Umayva/Diplom/RemoteFeeling/IDFReport_PCB2.html

Altium customize

# IDF File Translation Report

Date: | | 05.02.2024
Time: | | 11:31:06
Elapsed Time: | | 00:00:00
PCB Filename | : | D:\Documents\Diplom\RemoteFeeling\PCB2.PcbDoc
IDF Board Filename | : | D:\Documents\Diplom\RemoteFeeling\PCB2.brd
IDF Library Filename | : | D:\Documents\Diplom\RemoteFeeling\PCB2.pro

Errors

Back to top

Warnings

Back to top

Save Warnings

Back to top

Save Errors

Back to top

Export Warnings

Back to top

Export Errors

Back to top
