Umayva/Diplom/Разработка электрической схемы и создание действующего макета «.pptx

## Разработка электрической схемы и создание действующего макета «Перчатка с обратной тактильной связью»

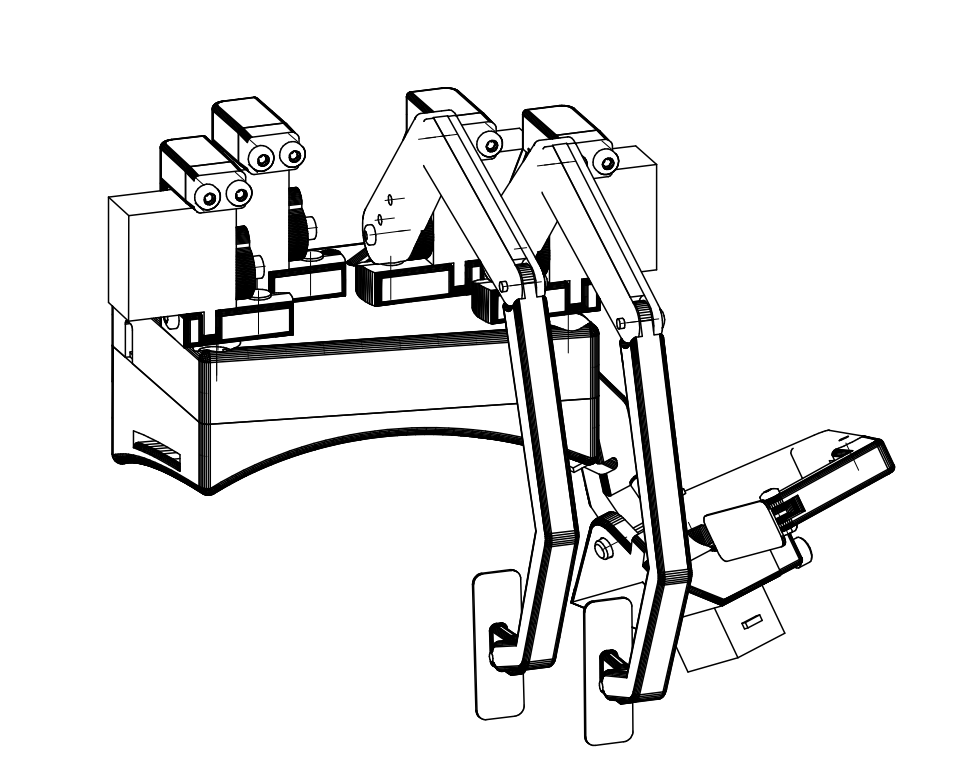
[picture p17: figure]

Выполнил Шамсиев М.А.
Руководитель Загидуллин Р.М.
Рецензент Галиуллин Э.Ф.

ГАПОУ «КРМК»
Гр. ЭПиУ – 460

## Slide 2

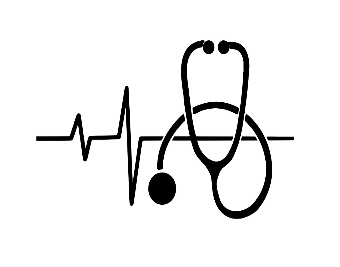
[picture p18: figure]
Picture background
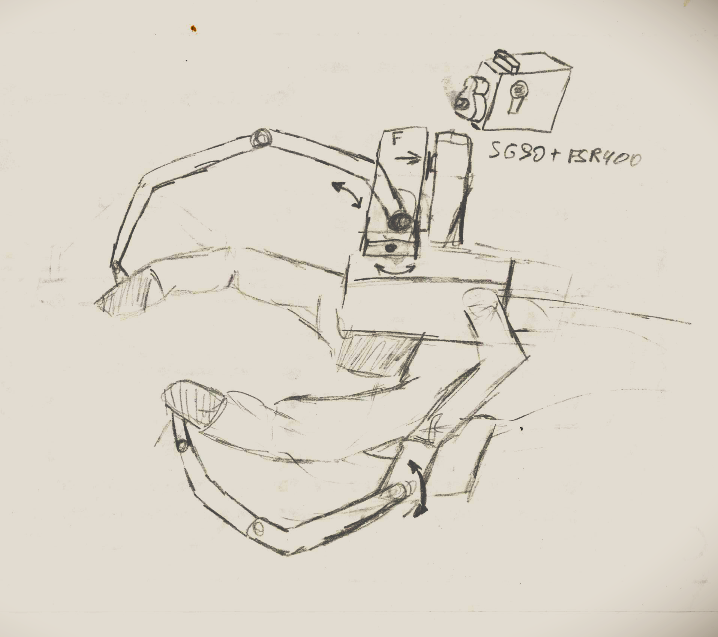
[picture p19: figure]

Медицина

Промышленность

Образование

Виртуальная
реальность

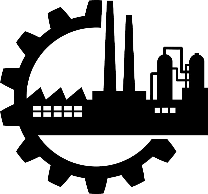
[picture p20: figure]
Picture background
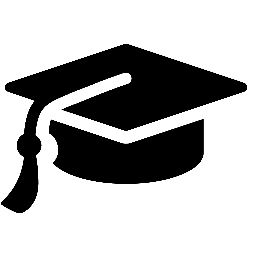
[picture p21: figure]
Picture background
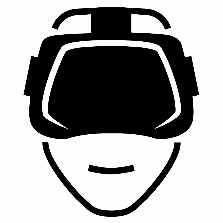
[picture p22: figure]
Picture background
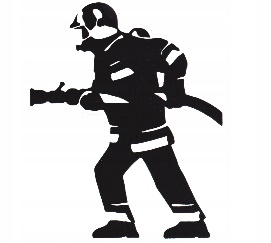
[picture p23: figure]
Picture background

Экстренные
службы

## Slide 3

Требования к прототипу
- Обеспечение полного перечня тактильных ощущений
- Автономность
- Малый удельный вес
- Беспроводная связь
- Низкая себестоимость

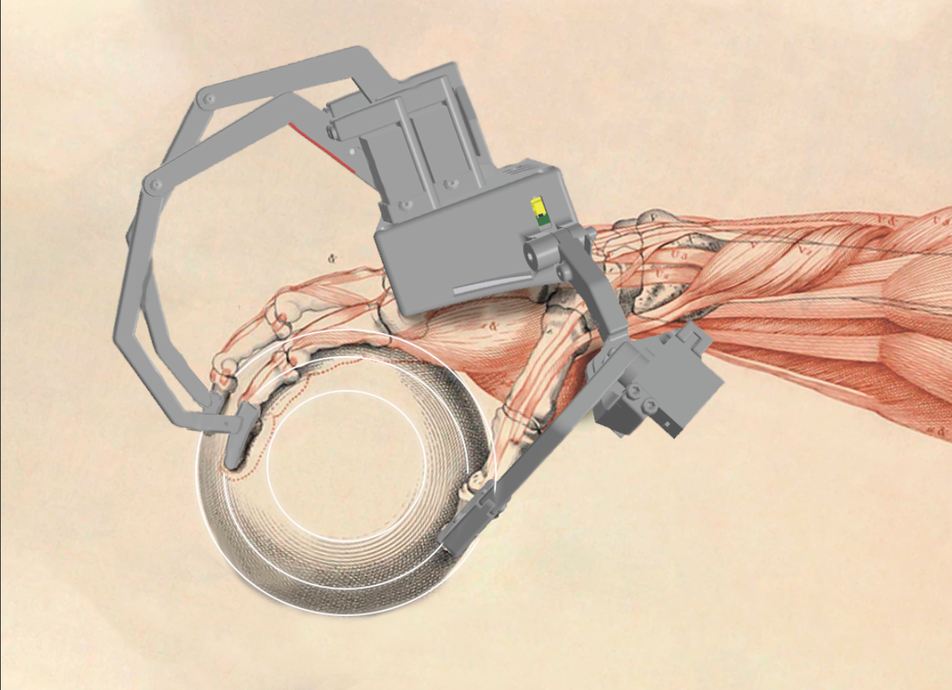
[picture p24: figure]
