Umayva/Diplom/курсовая/ебаный реферфат ПДП.docx

СОДЕРЖАНИЕ

# ВВЕДЕНИЕ

Производственная практика – это практическая часть учебного процесса подготовки квалифицированных рабочих и специалистов, проходящая, как правило на различных предприятиях, в условиях реального производства. Во время производственной практики происходит закрепление и конкретизация результатов теоретического учебно-практического обучения, приобретение студентами умения и навыков практической работы по присваиваемой квалификации и избранной специальности или профессии.

Преддипломная производственная практика: проходила на предприятии: ООО "Эйдос", с 22 апреля 2024 г. по 18 мая 2024 г.; в объеме 144 часа

Цель:

Продемонстрировать способы и методы применения теоретических знаний, полученных в течение семестра, на реальных рабочих местах.

Задачи:

1) Закрепление знаний, полученных на учебной практике

2) Изучение деятельности предприятия

3) Изучение оборудования предприятия

4) Анализ заводского технологического процесса

Приобретение необходимых навыков самостоятельной работы

# 1. Характеристика предприятия

ООО «ЭЙДОС» - это современная, инновационная и быстроразвивающаяся компания, специализирующаяся на разработке и производстве высокотехнологичных медицинских симуляторов под брэндом MedVision.

Результатом сотрудничества ООО «ЭЙДОС» и K.K. DNAFORM (Япония) стало создание в 2014 году компании K.K. MedVision (Япония). В рамках данного партнерства в период с 2014 года по настоящее время совместно были внедрены стандарты качества производства и разработки, созданы и представлены новые линейки симуляторов пациента и хирургических симуляторов, валидированных в Японии, США и Европе.

Поставщики симуляторов MedVision:

1. K.K. MedVision (Токио, Япония):
- Отдел исследований и разработок
- Отдел контроля качества
- Сервисный центр
- Отдел продаж в Японии
2. MedVision, LLC (Орландо, США):
- Сервисный центр
- Отдел продаж в Северной и Южной Америке
3. MedVision, GmbH (Вена, Австрия):
- Производство (ЕС)
- Отдел контроля качества
- Отдел продаж в ЕС
4. ООО «ЭЙДОС» (Казань, Россия):
- Производство
- Отдел исследований и разработок
- Сервисный центр

Схематично структуру подразделения нашего можно предоставить следующим образом (рисунок 1). Она не сильно отличается от среднестатистической структуры предприятия, т.к. и само предприятие не сильно отличается от большинства предприятий среднего бизнеса у нас в стране.

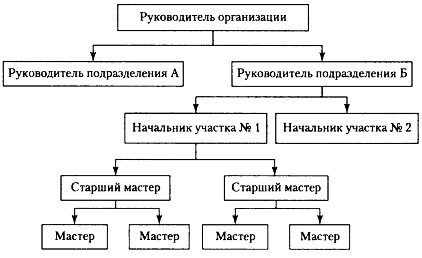
[picture p25: figure]

Рисунок 1 – структурная схема подразделения организации «ООО Эйдос»

# 2. ПРИНЦИП РАБОТЫ УСТРОЙСТВА И ПРИНЦИПИАЛЬНАЯ ЭЛЕКТРИЧЕСКАЯ СХЕМА

Принципиальная электрическая схема показана на рисунке 2.1. Устройство состоит из следующих функциональных частей:

- Датчики усилия, микровибро-мотор, сервоприводы, управляемые напрямую микроконтроллером (на данной схеме не указан, считается внешним элементом),
- Управляющего микроконтроллера DD2 ESP32-WROOM32E,
- Преобразователя интерфейса USB в UART DD4.
- Стабилизирующие цепи на стабилизаторах AMS1117 и LM7805
- Модуль зарядки на микросхеме DD1 TP5100 и цепь питания


Рисунок 2.1 - Принципиальная перчатки с обратной тактильной связью

Датчики усилия выведены на проводах через разъем XP8 представляют из себя тензорезистор включенный в цепь делителя напряжения через резисторы R11-R15 и для стабилизации данных датчика добавлены керамические конденсаторы С14-С18 и С21-С25 они монтируются в плату по необходимости

Основой вибромодуля является плоский микровибро-мотор, подключаемый в цепь через провод разъёмом XP4. Мотор работает от напряжения 3.3В и под него выделена отдельная цепь питания который рассмотрим позднее. Параллельно мотору подключен защитный диод VD1.

Для управление вибрацией микроконтроллером мы используем н-канальный MOSFET транзистор VT2 который работает в режиме ключа. Для обеспечения работы транзистора используем токоограничивающий резистор R7 и для разрядки затвора транзистора резистор R8.

Основой данного проекта являются переработанные сервоприводы sg90. Они подключены через шлейф разъемами XP1-XP6. Они были пронумерованы индексами T, I, M, R, P в соответствии с английскими наименованиями пальцев, далее в описании выводов будет справедливо отнести их каждому из индексов символом «*»

У них была выпаяна управляющая микросхема, таким образом мы подключаемся к драйверу мотора напрямую получая выводы *M1 и *M2.

Потенциометр сервопривода был изолирован из управляющей платы и получила выводы 3.3В и *E.

Питание пальцевые сервоприводы получают с выводов VCC и GND


Рисунок 2.2 – принципиальная схема управляющего микроконтроллера

За логику работы и реализации функционала устройства отвечает центральный микроконтроллер DD2 ESP 32 - WROOM32E.

ESP32 представляет собой серию недорогих, маломощных микроконтроллеров (https://en.wikipedia.org/wiki/System_on_a_chip) со встроенным Wi-Fi (https://en.wikipedia.org/wiki/Wi-Fi) и двухрежимным Bluetooth (https://en.wikipedia.org/wiki/Bluetooth).

В серии ESP32 используется либо микропроцессор Tensilica (https://en.wikipedia.org/wiki/Tensilica) Xtensa LX6 как в двухъядерном, так и в одноядерном (https://en.wikipedia.org/wiki/Single-core) исполнении, двухъядерный микропроцессор Xtensa LX7, либо одноядерный (https://en.wikipedia.org/wiki/Single-core) RISC-V (https://en.wikipedia.org/wiki/RISC-V) и включает встроенные антенные переключатели, радиочастотный (https://en.wikipedia.org/wiki/Radio_frequency) балун (https://en.wikipedia.org/wiki/Balun), усилитель мощности, малошумящий приемный усилитель, фильтры и модули управления питанием. ESP32 создан Espressif Systems (https://en.wikipedia.org/wiki/Espressif_Systems), китайской компанией, базирующейся в Шанхае, и производится TSMC (https://en.wikipedia.org/wiki/TSMC) по их 40-нм технологическому процессу.

Характеристики

- Процессоры:
  - Процессор: двухъядерный (или одноядерный) 32-разрядный микропроцессор Xtensa LX6, работающий на частоте 160 или 240 МГц и производящий до 600 DMIPS (https://en.wikipedia.org/wiki/Dhrystone)
  - Сопроцессор со сверхнизким энергопотреблением (ULP)
- Оперативная память: 520 Кб ОЗУ, 448 КБ ПЗУ
- Беспроводное подключение:
  - Wi-Fi: 802.11 (https://en.wikipedia.org/wiki/IEEE_802.11) b / g / n
  - Bluetooth: версии 4,2 с поддержкой EDR и BLE (совместно использует радио с Wi-Fi)

Питание микроконтроллера обеспечивается стабилизированным напряжением 3.3В. Для защиты от низкочастотных высокочастотных используем конденсаторы C1 и C2.

В качестве токоограничивающих резисторов на выводах последовательного интерфейса используем резистор R4 и R6.

Светодиод VD2 используется для индикации режима сброса, R3 в качестве токоограничения светодиода

Для ввода микроконтроллера в режим прошивки подтягиваем вывод IO0 к земле через тактовую кнопку SB2, для сброса микроконтроллера подтягиваем вывод EN к земле через кнопку SB1.

R5 и C3 для стабилизации работы процесса сброса


Рисунок 2.3 - Принципиальная схема преобразователя USB интерфейса в UART

DD4 CH340C - это микросхема-преобразователь шины USB, которая преобразует USB в последовательный порт или порт принтера. В режиме UART CH340 обеспечивает стандартные модемные сигналы, используемые для расширения последовательного порта для компьютеров или перехода непосредственно с обычного последовательного устройства на шину USB.

Цепь из транзисторов VT1 и VT3 служат для инициализации микросхемы DD4 с микроконтроллером. Резисторы R1 и R2 подключены к базам транзисторов для ограничения тока.

Для удобной прошивки устройства и связи с компьютером мы используем разъем Х1 micro USB. Для защиты прибора от воздействия статического электричества сигналы с разъема Х1 проходят через микросхему DD3 USB LC6 и конденсатор С4 для стабилизации.


Рисунок 2.4 - Принципиальная схема стабилизирующих цепей на стабилизаторах AMS1117

Питание 5В поступает на плату через разъем XP10. Для контроля мы используем кнопку SB1, он не монтируется на плате, а выведен за пределы корпуса проводами для легкого доступа. Диод шоттки VD3 B5819WS выполняет роль защиты от переполюсовки. Для индикации напряжения питания светодиод красного цвета VD7 и резистор R9 для его работы.

Стабилизаторы напряжения DA3 и DA2 представлены по класической схеме стабилизации от частотных помех с использованием конденсаторов C5 C6 C10 C11.


Рисунок 2.5 - Принципиальная схема цепи питания с модулем зарядки

Питание устройства обеспечивают два последовательно подключенных li-ion батареи G2 и G1

Характеристики

- Напряжение 3.5 В
- Емкость 3000 мАч
- Формфактор 18650

Батареи при последовательном соединении обеспечивают напряжение 8В, для преобразования этого значения до стабильных 5В используется стабилизатор DA1 LM7805

Для зарядки аккумуляторов был построен на базе микросхемы DD1 TP5100 - одна из наиболее широко используемых микросхем контроллера зарядки аккумулятора / BMS. Это простая и экономичная микросхема, предназначенная для портативных электронных устройств большой мощности. Одним из основных преимуществ микросхемы TP5100 является ее компактная и простая внешняя схема, для функционирования которой требуется всего несколько основных дополнительных компонентов.

Он имеет несколько функций безопасности для защиты аккумулятора и зарядного устройства от повреждений.

Обвязка микросхемы был выполнен согласно требованиям документации микросхемы TP5100

# 3. РАЗРАБОТКА КОНСТРУКЦИИ УСТРОЙСТВА

## 3.1 Описание конструкции


Устройство выполнено в виде отдельного конструктивного блока РЭА на рисунке 4.1

Рисунок 3.1 – внешний вид перчатки

При разборе заводских аналогов была выявлена самая главная проблема.

Средняя стоимость решений от компаний составляет от 250тыс рублей.

Наша задача, не теряя основной идеи подобного устройства разработать решение дешевле 20тыс рублей.

Требование к конструкции прототипа:

- Автономная работа
- Малый удельный вес устройства
- Беспроводная связь

## 3.2 Автономность

Одним из ключевых элементов, обеспечивающих автономность устройства, является отсутствие необходимости подключения к стационарным источникам питания через провода. Это особенно важно в нашем случае, поскольку наше устройство будет использоваться для виртуальных симуляций, где для достижения максимальной погруженности желательно избежать любых препятствий или ограничений для пользователя.


Исходя из вышеуказанных причин, мы приняли решение оснастить устройство аккумуляторной сборкой, состоящей из аккумуляторов 18650. Выбранные аккумуляторы имеют емкость 3000мАч, что позволяет обеспечить устройству достаточную энергию для продолжительной работы без необходимости подключения к сети электропитания. (Рисунок4.2)

Рисунок 3.2 – 3Д модель блока питания

## 3.3 Эргономика и развесовка

При использовании устройства необходимо обеспечить комфортное ощущение пользователю даже при длительной работе с ним. В процессе разработки перчатки особое внимание было уделено анатомическим особенностям среднего человека, чтобы создать корпус, который обеспечивает оптимальный уровень комфорта при использовании. Детально продуманная эргономика корпуса позволяет снизить вероятность возникновения дискомфорта или усталости при взаимодействии с устройством на протяжении длительного времени. (Рисунок3.3)


Рисунок 3.3 – Разработка эргономики корпуса

Одним из важнейших аспектов эргономики являются габаритные и весовые характеристики устройства. Эти параметры ограничивают возможности автономности устройства. Поскольку было принято решение использовать аккумуляторную сборку для питания, размещение ее в корпусе оказалось невозможным.

Во-первых, устройство стало бы слишком громоздким при таких габаритах. Во-вторых, вес блока питания составляет 260 грамм, а с учетом массы других компонентов и корпуса общий вес составляет 430 грамм. Такой вес может вызвать значительный дискомфорт уже после 15 минут активного использования, поскольку запястье будет нести на себе значительную часть нагрузки.


Исходя из вышеупомянутых причин, было принято решение вынести блок питания за пределы корпуса устройства. Детали конструкции блока питания представлены на рисунке 3.3. Однако использование длинного провода также может быть неудобным, поэтому сборка аккумуляторов будет крепиться к предплечью пользователя. Это не только решит проблему с весом, но и позволит равномерно распределить нагрузку по всей руке (Рисунок 3.4).

Рисунок 3.4 – Распределение нагрузки

## 3.4 Беспроводная связь

В целях обеспечения полной автономности перчатки, необходимо, помимо использования переносного источника энергии, также организовать беспроводную связь с внешними устройствами. С этой целью был выбран ESP32 в качестве микроконтроллера, который обладает встроенными функциями Wi-Fi и Bluetooth, что обеспечивает возможность установки беспроводной связи между перчаткой и другими устройствами. Кроме того, ESP32 имеет контакты для аналого-цифровых преобразователей (АЦП) и цифро-аналоговых преобразователей (ЦАП).

Технология BLE (Bluetooth Low Energy), как следует из ее названия, потребляет значительно меньше энергии чем классический (classic) Bluetooth. Это достигается при помощи передачи данных по требованию с заранее определенными периодическими обновлениями. Но в отличие от классического Bluetooth технология BLE не используется для передачи файлов или музыки. Наверное, вы были неоднократно удивлены тем, что когда вы подключаете к вашему смартфону какой-нибудь фитнес браслет или умные часы, то вы в своем смартфоне можете посмотреть и уровень заряда батареи подключенного устройства – этот функционал становится доступен благодаря использованию технологии BLE. Данная технология работает вместе с версией Bluetooth V4.0 и может использоваться в серверных или клиентских устройствах, что делает ее чрезвычайно удобной для применения в умных часах, фитнес браслетах и т.д.

Классический Bluetooth, в то же время, достаточно удобен для передачи файлов и других данных. Практически все BLE устройства поддерживают и функционал классического Bluetooth.

Bluetooth, который используется в модулях подобных HC-05, является версией классического Bluetooth и называется Bluetooth SSP (Serial Port Protocol – протокол последовательного порта), что означает то, что в данном случае Bluetooth использует стандартный последовательный протокол.

В данной статье мы будем использовать функционал Serial Bluetooth (последовательного) в модуле ESP32 для его соединения со смартфоном, на котором запущено приложение Bluetooth Terminal. Из данного приложения мы будем передавать команды, с помощью которых мы будем включать/выключать встроенный светодиод модуля ESP32.

## 3.2 Расчет функционального узла печатной платы

В данной дипломной работе электрическая схема задается, чтобы произвести разработку конструкции и решение других конструкторских задач. Данная схема не имеет перечня элементов, а их название и номиналы указываются непосредственно на схеме. В связи с этим, ознакомившись со схемой, возникает необходимость в дополнении и уточнении элементной базы и произвести разработку трассировки печатной платы. Для решения этих задач об элементной базе нужно знать:

1. Габаритные (установочные) размеры, XU*YU*ZU.

2. Массу, ME.

3. Рабочие напряжение и мощность.

Трудность выбора элементной базы заключается в том, что на данный момент большое многообразие элементов с разными характеристиками и конструкциями. Также вызывает затруднение выбор подходящих коммутационных изделий.

Результаты анализа и выбора элементной базы представлены в таблице 3.1

Таблица 3.1 Результаты анализа и выбора элементной базы

Название | Тип | Рисунок с размерами | Масса, г | Место установки
| | | | ПП | ЛП | ЗП

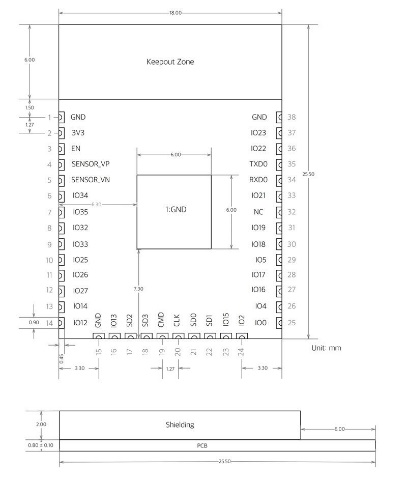
[picture p26: figure]
Picture background

микроконторллер Wi-Fi ESP WROOM 32 | | | 2,18 | +

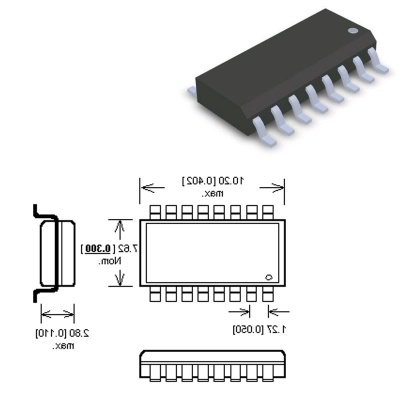
[picture p27: figure]
Picture background

CH340C, Преобразователь интерфейса USB в UART [ | SOP-16 | | 0.4 | +

Продолжение таблицы 3.1 Результаты анализа и выбора элементной базы

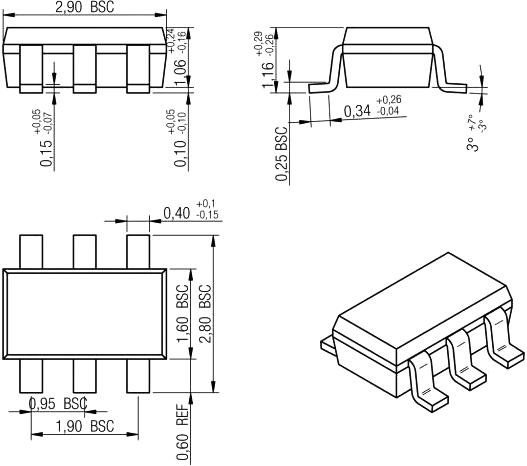
[picture p28: figure]
Picture background

USBLC6-2SC6 | SOT-23-6 | | 0,1 | +

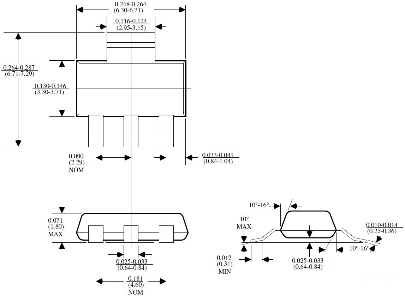
[picture p29: figure]
Picture background

AMS1117-3,3 | SOT-223 | | 0,39 | +

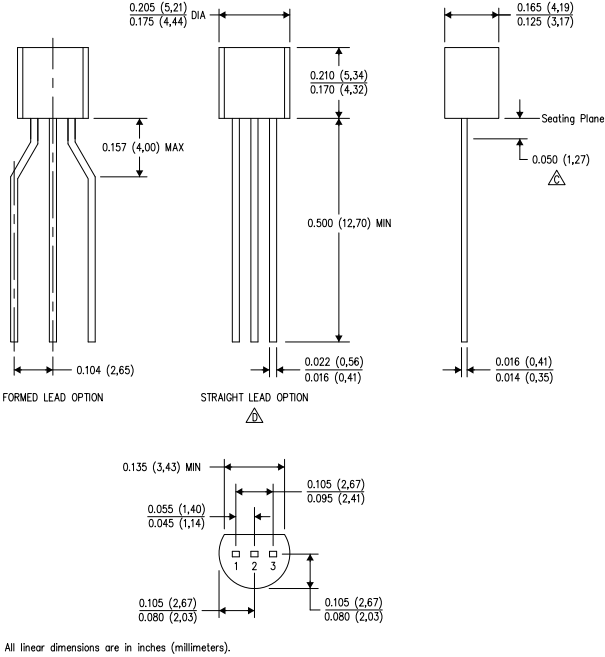
[picture p30: figure]
Picture background

2N7000 | TO-92 | | 0,3 | +

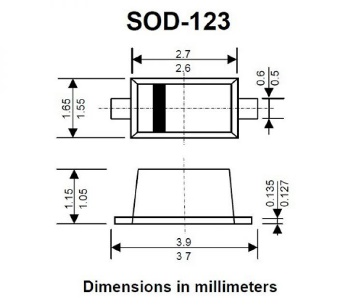
[picture p31: figure]
Picture background

1N4148W, | SOD-123 | | 0,05 | +

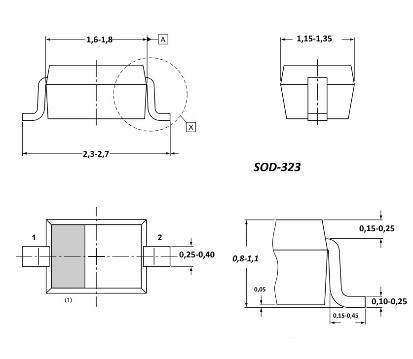
[picture p32: figure]
Picture background

B5819WS, | SOD-323 | | 0,1 | +

Продолжение таблицы 3.1 Результаты анализа и выбора элементной базы

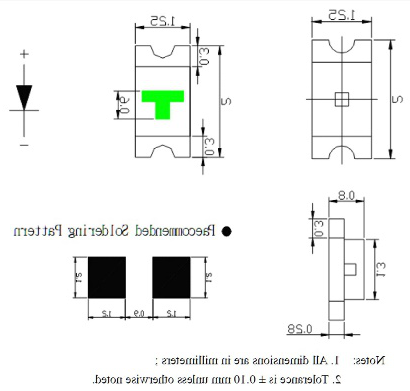
[picture p33: figure]
Picture background

GNL-0805SR | 0805 | | 0,1 | +

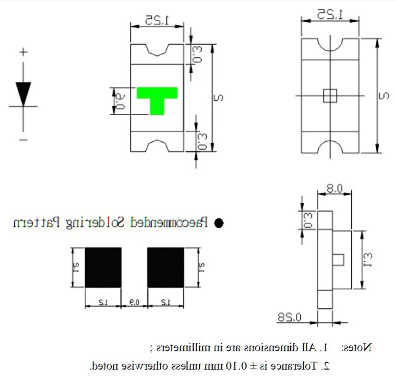
[picture p34: figure]
Picture background

GNL-0805GC | 0805 | | 0,1 | +

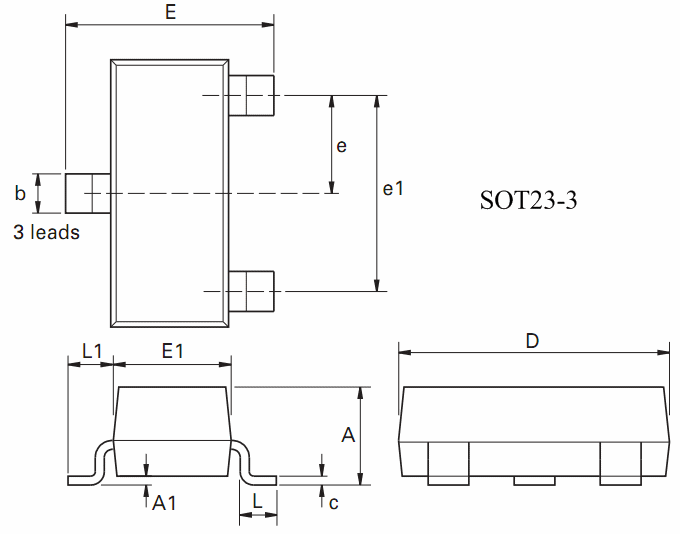
[picture p35: figure]
Picture background

S8050 | SOT-23-3 | | 0,05 | +

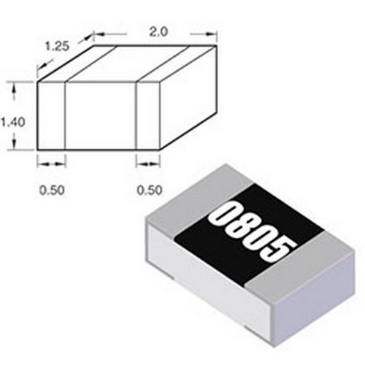
[picture p36: figure]
Picture background

0,1мкф X7R 100в 10% | 0805 | | 0,01 | +

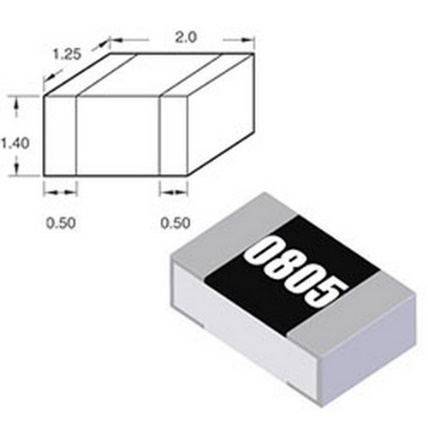
[picture p37: figure]
Picture background

10 мкФ X5R 16В 10% | 08085 | | 0,01 | +

Продолжение таблицы 3.1 Результаты анализа и выбора элементной базы

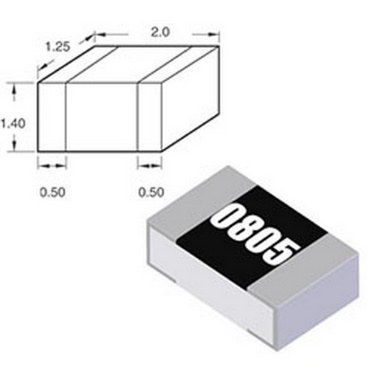
[picture p38: figure]
Picture background

100кОм +0.1% | 0805 | | 0,01 | +

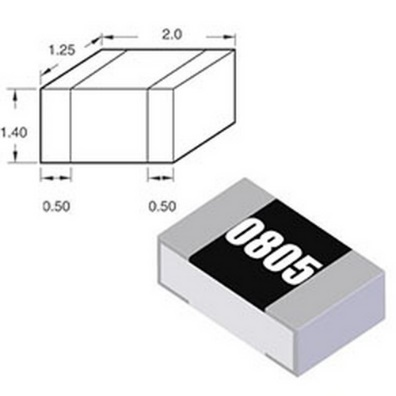
[picture p39: figure]
Picture background

2кОм ±5% 0.125Вт | 0805 | | 0,01 | +

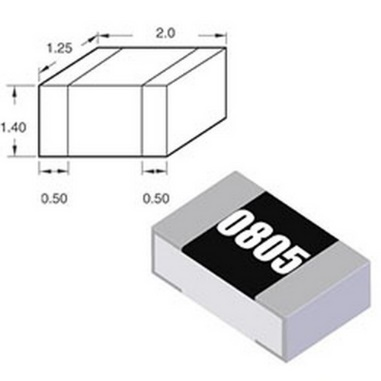
[picture p40: figure]
Picture background

470 Ом, 1% | 0805 | | 0,01 | +

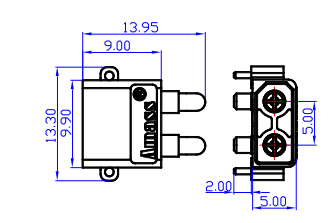
[picture p41: figure]

XT30PW-M, | | | 1

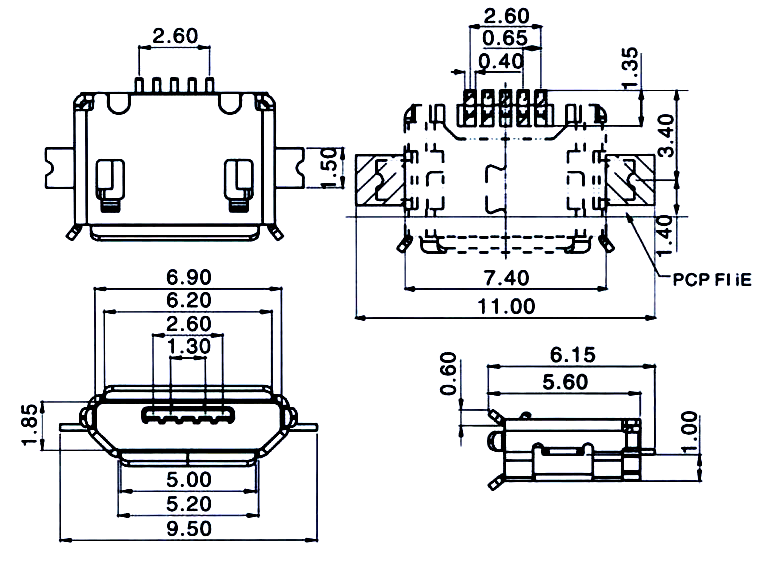
[picture p42: figure]
Picture background

47346-0001 | | | 0,25

Продолжение таблицы 3.1 Результаты анализа и выбора элементной базы

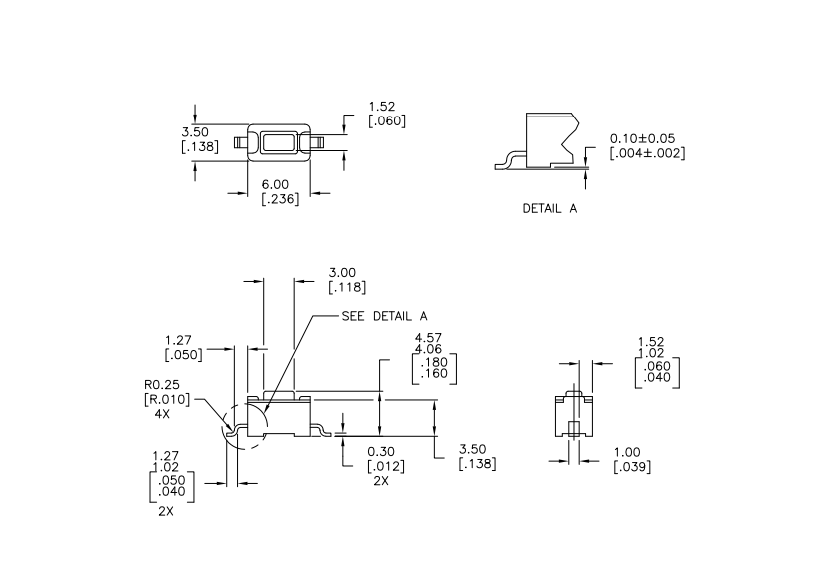
[picture p43: figure]

1437566-3 (FSMSM) | | | 0,13

Предпочтительная форма печатной платы. Она определяется XP, YP, h и коэффициентом формы CF=XP/YP,

ХР> YP; X1, X2, Y1, Y2-краевые поля, необходимые для удобства изготовления и закрепления платы.

XF*YF=SF - размеры и площадь функциональной области, где размещаются элементы электрической схемы и соединительные пробойники.

Площадь, занимаемая элементами на плате.

Вычисляется по формуле (1) и равняется:

CE=∑_(i=1)^n SU_i =769.18мм^2 (1)

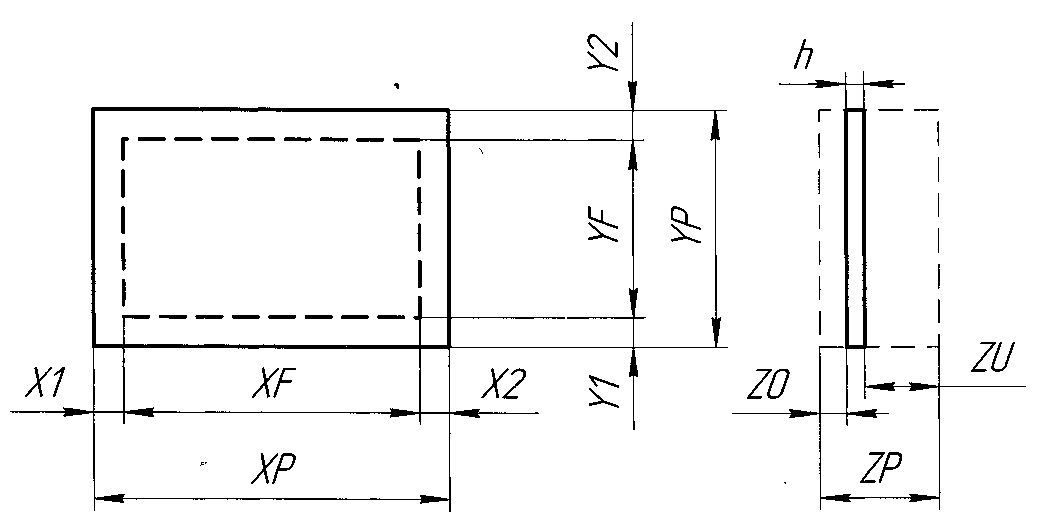
[picture p44: figure]

Рисунок 3.5 - Размеры печатной платы

Согласно рисунка 3.5 размеры печатной платы - определяются размерными цепочками:

XP=X1+XF+X2 (2a)

YP=Y1+YF+Y2 (2б)

Размеры печатного узла по третьей координате-

ZP=ZUmax+h+ZOmax (3)

(h-толщина материала печатной платы)

h=0,5мм

ZP=11+0,5+1=12,5мм

CZ-коэффициент заполнения по площади.

При равенстве CZ(X)=CZ(Y)=√CZ,

CZ-статическая Величина и составляет CZ=0,304

С учётом зазоров между элементами, площадь функциональной поверхности платы найдётся по формуле (4) как

SF=(SE)/(CZ)=1216/0.304=4000мм^2 (4)

Ширина краевых полей выбирается кратной шагу координатной сетки X1,X2,Y1,Y2 = 2,5

Коэффициент формы платы CF=XF/YF=XP/YP,

согласно ГОСТ 10716-81 1≤CF≤3;

CF=1,6

Диаметр контактной площадки согласно рис 4.6 а, находится как DK=2xXA+D=2 0,7+0,8=2,2 мм

где ХА - ширина проводника, D-диаметр отверстия в плате для установки вывода элемента DV, рис 4.6 б.

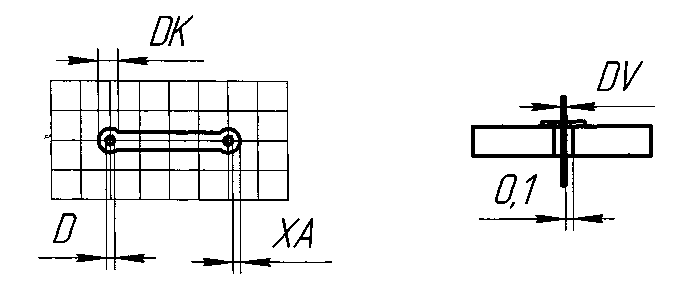
[picture p45: figure]

а б

Рисунок 4.6 (а, б) - Размер контактной площадки

Для каждой толщины подсчитаем значение диаметра контактной площадки

D1=DV1+0,2=0,5+0,2=0,7 мм

D2=DV2+0,2=0,6+0,2=0,8 мм

Выбираем D1=D2=0,8 мм

В данном случае целесообразно использовать следующие размеры печатной платы

XP=X1+XF+X2=2,5+75+2,5=80 мм

YP=Y1+YF+Y2=2,5+45+2,5=50 мм

Получен коэффициент прямоугольности 1,6

Размеры плоты XP XYP=80*50 мм

Функциональные узлы, использующие интегральные схемы, работают на токах, не превышающие 10⁻²...10⁻⁴А через проводники сигнальных цепей.

В данном устройстве токи не могут превышать 1СГ3А. Ширину проводника ХА возьмём равной 0,3мм. Удельная плотность тока через печатного проводника равный - 25 А/мм².

Подсчитаем значение толщины фольги по формуле (5):

TF=(10^(-3))/(y*XA)=(10^(-3))/(25*03)=14мкм (5)

В результате расчётов получилось толщина фольги 14 мкм, возьмём стандартную толщину фольги 18 мкм.

Полученные габаритные размеры функционального узла - 80х50х0,5мм подходящей материал для изготовления печатной платы - стеклотекстолит, фольгированный гальваностойкий СФ-2-18-Г.

# 4. ЭКОНОМИЧЕСКИЙ РАЗДЕЛ

## 4.1 Общие положения

Задачей экономической части дипломной является расчёт затрат на изготовление изделия «Перчатка с обратной тактильной связью» при серийном производстве на предприятии.

Расходы предприятия - это расходы, связанные с изготовлением и продажей продукции, приобретением и перепродажей товаров, выполнением работ или оказанием услуг. Совокупность всех расходов предприятия, возникающих в процессе переработки материально-производственных запасов для целей производства продукции и её продажи.

- материальные затраты;

- затраты на оплату труда;

- отчисления на социальные нужды;

- амортизация основных фондов;

При этом по элементу «Материальные затраты» отражается стоимость покупных основных и вспомогательных материалов, изделий, топлива, энергии, услуг производственного характера сторонних организаций. Их стоимость формируется исходя из цен приобретения (без учёта НДС), включая наценку (надбавку), комиссионное вознаграждение, оплату брокерских и иных посреднических услуг. Оплата труда и отчисления на социальные нужды отражаются только применительно к персоналу основной деятельности.

Элемент «Амортизация основных фондов» учитывает величину амортизационных отчислений на полное восстановление основных производственных фондов, сумма которых, определяется на основании их балансовой стоимости и действующих норм амортизации. В элемент

«Прочие затраты» включаются некоторые виды сборов и платежей, отчисления в специальные внебюджетные фонды, платежи за предельно допустимые выбросы загрязняющих веществ и другие.

В процессе анализа учитывается удельный вес каждого элемента затрат в общей сумме себестоимости, исходя из особенностей тех или иных отраслей. Затраты, формирующие себестоимость продукции, составляют подавляющую часть расходов предприятия. Поэтому их величина напрямую влияет на размер прибыли, получаемой предприятием.

Расчет затрат на элементную базу

Для расчета затрат на элементную базу необходимо составить перечень необходимых элементов и рассчитать их стоимость. В таблице 4.2 перечислены элементы, необходимые для создания прототипа прерчатки:

Цэ= ∑ э*Р (6)

Где: Цэ - цена элементов (руб.);

∑э – количество элементов;

Р – цена одного элемента (руб.)

Таблица 4.2 Список деталей

№ | Название | Цена за партию с НДС 20% (руб) | Количество деталей в партии (Ед) | Цена за деталь (руб) | Количество деталей на единицу изделия | Цена на еденицу изделия (руб)
1 | печатная плата jlcpcb 5шт | 1 789,2 | 5 | 357.8 | 1 | 357.8
2 | Датчик давления FSR400 | 187,2 ₽ | 1 | 187,2 ₽ | 5 | 936.0
3 | Сервопривод sg90 5шт | 1 208,4 ₽ | 5 | 240 | 5 | 1 208,4
4 | Шлейф 1.2мм 9жил 2м | 223.2 | 2 | 111.6 | 1.5 | 167.4
5 | Винт с шестигранной головкой ISO7380 М2,5х16 | 181,2 | 50 | 3.6 | 5 | 18.1
6 | Винт с шестигранной головкой ISO7380 М2х10 | 141,6 | 50 | 2.8 | 5 | 14.2
7 | 3x4x6 Низкопрофильный прецизионный плечевой винт из нержавеющей стали 18-8 | 343,1 | 1 | 343,1 | 1 | 343,1
8 | 3x4x4 Низкопрофильный прецизионный плечевой винт из нержавеющей стали 18-8 | 274,1 | 1 | 274,1 | 4 | 1096.3
9 | 3x4x16 Низкопрофильный прецизионный плечевой винт из нержавеющей стали 18-8 | 343,1 | 1 | 343,1 | 1 | 343,1
10 | Плоский вибромотор BVM 1027 10мм 3В для Arduino проектов CT Retail | 180,0 | 1 | 180,0 | 1 | 180,0
11 | микроконторллер Wi-Fi ESP WROOM 32 | 312,0 | 1 | 312,0 | 1 | 312,0
12 | CH340C, Преобразователь интерфейса USB в UART [SOP-16] | 118,8 | 1 | 118,8 | 1 | 118,8
13 | USBLC6-2SC6, Защита интерфейса USB от электростатических разрядов [SOT-23-6] | 30,0 | 1 | 30,0 | 1 | 30,0
14 | LM7805Стабилизатор напряжения, линейный,нерегулируемый, 5В, 2,2А | 240,0 | 1 | 240,0 | 1 | 240,0

Продолжение Таблицы 4.2 Список деталей

15 | AMS1117-3,3, Линейный регулятор с малым падением напряжения, 1А, 3,3В [SOT-223] | 10,8 | 1 | 10,8 | 2 | 21,6
16 | 2N7000, Транзистор, N-канал, 60В, 0.2А [TO-92] | 8,4 | 1 | 8,4 | 1 | 8,4
17 | 1N4148W, Диод 100В 0.15А [SOD-123] | 3,6 | 1 | 3,6 | 1 | 3,6
18 | B5819WS, Диод Шоттки 40В 1А [SOD-323] | 4,8 | 1 | 4,8 | 1 | 4,8
19 | GNL-0805SRC, Светодиод красный SMD 0603 9-15мКд 120° 660нМ | 14,4 | 1 | 14,4 | 1 | 14,4
20 | GNL-0805GC, Светодиод зеленый SMD 0603 7-12мКд 120° 567нМ | 14,4 | 1 | 14,4 | 1 | 14,4
21 | S8050, Транзистор NPN 25В 0.5А HFE=120…400 0.3Вт [SOT-23-3] | 4,8 | 1 | 4,8 | 2 | 9,6
22 | Конденсатор керамический smd 10 мкФ X5R 16В 10% 0805 | 8,4 | 1 | 8,4 | 7 | 58,8
23 | 0,1мкф X7R 100в 10% (0805) Чип керам,конденсатор TCC0805X7R104K101FT | 2,4 | 1 | 2,4 | 13 | 31,2
24 | RT0805BRD07100KL, (чип 0805 100К 0.1% +25ppm/°C), Тонкопленочный ЧИП-резистор 0805 100кОм +0.1% 0.125Вт - | 7,2 | 1 | 7,2 | 5 | 36,0
25 | RS-05K202JT, ЧИП-резистор 0805 2кОм ±5% 0.125Вт -55°C...+155°C | 3,6 | 1 | 3,6 | 2 | 7,2
26 | Резистор постоянный SMD 0805 10K 0.5% / RT0805DRE0710KL | 2,4 | 1 | 2,4 | 4 | 9,6
27 | 0.125Вт 0805 470 Ом, 1%, Чип резистор (SMD) | 4,8 | 1 | 4,8 | 2 | 9,6
29 | 47346-0001, Разъем micro USB-B | 168,0 | 1 | 168,0 | 1 | 168,0

Продолжение Таблицы 4.2 Список деталей

30 | XT30PW-M, Разъем питания штекер на плату угловой 2pin | 216,0 | 1 | 216,0 | 1 | 216,0
31 | XT30U-F, Вилка питания DC XT30 "мама" провод под пайку Цвет желтый | 168,0 | 1 | 168,0 | 1 | 168,0
32 | Плата модуля питания TP5100 для управления зарядкой | 51,6 | 1 | 51,6 | 1 | 51,6
33 | Аккумулятор li-ion, 3000 мАч, 5 шт | 1 184,4 | 5 | 1 184,4 | 2 | 473,8
34 | Батарейный отсек для аккумуляторов 2 x 18650 Li-ion с проводами | 159,6 | 1 | 159,6 | 1 | 159,6
35 | Стяжки на липучке, ремешок фиксатор 5шт. | 552,0 | 5 | 552,0 | 2 | 220,8
36 | Защитные накладки на кончики пальцев для гитары 10 шт | 430,8 | 10 | 430,8 | 5 | 215,4

Цэ= ∑ э*Р=7 633,2 ₽

## 4.2 Расчет стоимости материалов

Основные материалы, используемые на единицу изделия и расчет затрат на них приведен в таблице 4.3.

Таблица 4.3 Список материалов

№ | Наименование материалов | Еди ницыизме- рения | Коли- чество единиц mi | Цена за единицу изделия Цi , руб | Стои- мость в руб. mi * Цi
1 | Спирто-нефрасовая смесь 1։1= | л | 0,07 | 38 | 2,66
2 | Припой Прв КР2 ПОС – 61= | кг | 0,03 | 283 | 8,49
3 | Флюс ФКС 40%= | кг | 0,02 | 6 | 0,12
4 | Лак УР – 231. Т2.4= | л | 0,02 | 370 | 7,4
6 | Сплав Розе= | кг | 0,001 | 420 | 0,42
7 | Канифоль сосновая | кг | 0,16 | 300 | 48
8 | Краска МКЭ черная | л | 6,0 | 10 | 60
9 | Клей ВК - 9 | кг | 0,008 | 56 | 0,448
10 | Пластик для 3D принтера PLA Geekfilament 1.75мм, | кг | 0,2 | 257 | 51,4
| Итого | | | | 178,94

## 4.3 Стоимость сырья и материалов на единицу проектируемого изделия

Стоимость сырья и материалов на единицу проектируемого изделия, необходимых для изготовления, рассчитывается по формуле:

= 178,94руб. (7)

где: - количество материалов

- цена за единицу материала, руб.

m –количество, наименований материалов.

Расчет стоимости оборудования

Производим расчёт оборудования, необходимого для организации работы:

Таблица 5.4 Список оборудования

№ | Название | Цена в том числе с НДС, руб.
1 | Стол радиомонтажника VikingКомплект Классик СР-2 | 26 330
2 | Термовоздушная паяльная станция МЕГЕОН 00550 к0000020550 | 13 566,0
3 | Лампа для местного освещения | 2 500
4 | Лупа 5Х на струбцине с подсветкойRexant 31 - 0532 | 5 300
5 | Верстак с тумбой 1200x685x850 Gigant ВТ G-ВТ-1.2 | 16 769
6 | Сверлильный станок (9 скоростей, 400Вт, D13мм) Zitrek DP-82 067-4010 | 7 369
7 | Угловая шлифмашина Bosch GWS 660 0.601.375.08N | 2 726
8 | Ноутбук Honor MagicBook 14 5301AFLS, 14", IPS, AMD Ryzen 5 5500U 2.1ГГц, 6-ядерный, | 43 990,0
9 | 3D-принтер Flying Bear Ghost 5, | 21 863,3
10 | Прямошлифовальная машинка Ryobi EHT150V 5133000754 | 5 554,0
11 | Набор отверток из стали S2 КВТ Мастер НО-06-S 78622 | 729,0
12 | JIMI JM-GNT80 80 в 1 прецизионные отвертки многофункциональные | 3 398,0
13 | Автоматический цифровой мультиметр Вымпел VC835 5228 | 2 231,0
14 | Набор шарнирно-губцевого инструмента Tactix Ergo 204025, 5 предм. | 3 623,0
15 | Источник питания VERDO PP1106 60 В, 10А, 300 Вт PP110600 | 21 650,0
| Итого | 177598

## 4.4 Расчет стоимости программного обеспечения (ПО)

Производим расчёт стоимости программного обеспечения, необходимого для организации работы:

Таблица 4.5 Список ПО

№ | Название | Цена в том числе с НДС, руб.
1 | КОМПАС-3D v19 | 169 000
2 | Altiumdisigner | 600 000
3 | Visual Studio Code | 0
| Итого | 769 000

## 4.5 Расчет фонда заработной платы

Для расчета основной заработной платы производственных рабочих, занимающихся сборкой и монтажом проектированного изделия, данные представлены в таблице 4.6.

Таблица 4.6 Фонд оплаты труда

Профессия и разряд рабочего | Количество часов за смену | Часовая тарифная ставка | Основная заработная плата за смену ЗПо
Радиомонтажник VI разряда | 8 | 350 | 2800
Инженер программист | 8 | 500 | 4000
Регулировщик VI разряда | 8 | 450 | 3600
Сборщик VI разряда | 8 | 250 | 2000

Для расчета дополнительной заработной платы производственных рабочих, занимающихся сборкой и монтажом проектированного изделия, данные представлены в таблице 4.7.

Таблица 4.7 Дополнительная оплата труда

Профессия и разряд рабочего | Основная заработная плата за смену | Процент дополнительной заработной платы | Дополнительная заработная плата за смену ЗПд
Радиомонтажник VI разряда | 2800 | 30% | 840
Инженер программист | 4000 | 30% | 1200
Регулировщик VI разряда | 3600 | 30% | 1080
Сборщик VI разряда | 2000 | 30% | 600

Суммарная заработная плата (основная и дополнительная) производственных рабочих, данные представлены в таблице 4.8.

Таблица 4.8 Итоговый фонд оплаты труда

Профессия и разряд рабочего | Основная заработная плата за смену | Дополнительная заработная плата за смену | Суммарная заработная плата за смену
Радиомонтажник VI разряда | 2800 | 840 | 3640
Инженер программист | 4000 | 1200 | 5200
Регулировщик VI разряда | 3600 | 1080 | 4680
Сборщик VI разряда | 2000 | 600 | 2600

Чтобы рассчитать страховую часть с заработной платы, прежде всего необходимо определить вид страхования и выплату по ним, данные представлены в таблице 4.9.

Таблица 4.9 Страховые выплаты

Профессия и разряд рабочего | ПФР (обязательное пенсионное страхование) 22% | ФФОМС (обязательное медицинское страхование) 5,1% | ФСС (обязательное социальное страхование в связи с временной нетрудоспособностью и материнством) 2,9% | ОСС НС и ПЗ (обязательное социальное страхование от несчастного случая и профессиональных заболеваний) 2,1%
Радиомонтажник VI разряда | 800,8 | 185,64 | 105,56 | 76,44
Инженер программист | 1144 | 265,2 | 150,8 | 109,2
Регулировщик VI разряда | 1029,6 | 238,68 | 135,72 | 98,28
Сборщик VI разряда | 572 | 132,6 | 75,4 | 54,6

Данные для расчёта НДФЛ представлены в таблице 4.10.

Таблица 4.10 Налогообложение

Профессия и разряд рабочего | НДФЛ 13%
Радиомонтажник VI разряда | 473,2
Инженер программист | 676
Регулировщик VI разряда | 608,4
Сборщик VI разряда | 338

Определяем фонд оплаты труда за смену по каждому работнику, чтобы в дальнейшем определить затраты по заработной плате на единицу изделия:

Таблица 4.11 Оплата труда за смену

Профессия и разряд рабочего | Кол-во изделия в смену | ФОТ | ФОТ на единицу изделия
Радиомонтажник VI разряда | 1 шт. | 5281,64 | 5281,64
Инженер программист | 1 шт. | 7545,2 | 7545,2
Регулировщик VI разряда | 1 шт. | 6790,68 | 6790,68
СборщикVI разряда | 1 шт. | 3772,6 | 3772,6
Всего ФОТ по всем работникам на ед.изделия | 1 шт. | 23390,12 | 23390,12

## 4.6 Расчёт амортизации основных фондов

Амортизация – есть денежное выражение износа.

Норма амортизации в месяц:

На = (1 / t) * 100%

На = (1 / 5*12) * 100% = 1,67%

Сумма амортизации в месяц:

А = (Фп * На) / 100%

Сумма амортизации на единицу изделия:

Аед.из = А/Кр.д

где: Кр.д. – количество рабочих дней в месяц.

Таблица 4.12 Амортизация

№ | Название | Цена в том числе с НДС, руб. Фп | Срок использования оборудования мес. | Сумма амортизации в месяц. | Сумма амортизации в день | Сумма амортизации на единицу продукци
1 | Стол радиомонтажника VikingКомплект Классик СР-2 | 26 330 | 60 | 438,8 | 14,6 | 14,6
2 | Термовоздушная паяльная станция МЕГЕОН 00550 к0000020550 | 13 566,0 | 40 | 339,2 | 11,3 | 11,3
3 | Лампа для местного освещения | 2 500 | 60 | 41,7 | 1,4 | 1,4
4 | Лупа 5Х на струбцине с подсветкойRexant 31 - 0532 | 5 300 | 60 | 88,3 | 2,9 | 2,9
5 | Верстак с тумбой 1200x685x850 Gigant ВТ G-ВТ-1.2 | 16 769 | 60 | 279,5 | 9,3 | 9,3
6 | Сверлильный станок (9 скоростей, 400Вт, D13мм) Zitrek DP-82 067-4010 | 7 369 | 60 | 122,8 | 4,1 | 4,1
7 | Угловая шлифмашина Bosch GWS 660 0.601.375.08N | 2 726 | 60 | 45,4 | 1,5 | 1,5
8 | Ноутбук Honor MagicBook 14 5301AFLS, 14", IPS, AMD Ryzen 5 5500U 2.1ГГц, 6-ядерный, | 43 990,0 | 24 | 1832,9 | 61,1 | 61,1
9 | 3D-принтер Flying Bear Ghost 5, | 21 863,3 | 24 | 911,0 | 30,4 | 30,4
10 | Прямошлифовальная машинка Ryobi EHT150V 5133000754 | 5 554,0 | 60 | 92,6 | 3,1 | 3,1
11 | Набор отверток из стали S2 КВТ Мастер НО-06-S 78622 | 729,0 | 80 | 9,1 | 0,3 | 0,3

Продолжение Таблицы 4.12 Амортизация

12 | JIMI JM-GNT80 80 в 1 прецизионные отвертки многофункциональные | 3 398,0 | 60 | 56,6 | 1,9 | 1,9
13 | Автоматический цифровой мультиметр Вымпел VC835 5228 | 2 231,0 | 40 | 55,8 | 1,9 | 1,9
14 | Набор шарнирно-губцевого инструмента Tactix Ergo 204025, 5 предм. | 3 623,0 | 80 | 45,3 | 1,5 | 1,5
15 | Источник питания VERDO PP1106 60 В, 10А, 300 Вт PP110600 | 21 650,0 | 40 | 541,3 | 18,0 | 18,0
| Итого: | 177 598 | | 4900,2 | 163,3 | 163,3

## 4.7 Расчёт постоянных затрат

Затраты на оплату силовой электроэнергии, потребляемой оборудованием.

Зс.эл.= к * Роб * n * Тсм * СкВт-ч (руб.) (8)

где: к – коэффициент, учитывающий неравномерность использования оборудования, к = 0,65;

Роб – суммарная мощность оборудования, кВт;

n – число смен работы в сутки;

Тсм – продолжительность смены, час.;

СкВт-ч – стоимость одного кВт электроэнергии, руб. (4,79руб.)

Таблица 4.1 Затраты на электроэнергию

№ | Название | Мощность оборудования кВт | Силовая электроэнергия (за смену) Зс.эл. | Силовая электроэнергия (за ед.изделия) Зс.эл.
1 | Стол радиомонтажника VikingКомплект Классик СР-2 | 0,054 | 1,35 | 1,35
2 | Станция паяльная термовоздушная + паялникLUKEY - 868 | 0,75 | 18,68 | 18,68
3 | Лампа для местного освещения | 0,1 | 2,49 | 2,49
4 | Лупа 5Х на струбцине с подсветкойRexant 31 - 0532 | 0,011 | 0,27 | 0,27
5 | Верстак с тумбой 1200x685x850 Gigant ВТ G-ВТ-1.2 | 0,054 | 1,35 | 1,35
6 | Сверлильный станок (9 скоростей, 400Вт, D13мм) Zitrek DP-82 067-4010 | 0,4 | 9,96 | 9,96
7 | Угловая шлифмашина Bosch GWS 660 0.601.375.08N | 0,66 | 16,44 | 16,44
8 | Ноутбук Honor MagicBook 14 5301AFLS, 14", IPS, AMD Ryzen 5 5500U 2.1ГГц, 6-ядерный, | 0,065 | 1,62 | 1,62
9 | 3D-принтер Flying Bear Ghost 5, | 0,3 | 7,47 | 7,47
10 | Прямошлифовальная машинка Ryobi EHT150V 5133000754 | 0,15 | 3,74 | 3,74
11 | Источник питания VERDO PP1106 60 В, 10А, 300 Вт PP110600 | 0,3 | 7,47 | 7,47
| Итого: | | 70,84 | 70,84

## 4.7 Расчёт себестоимости изделия

Составляем калькуляцию себестоимости на единицу изделия (таблица 4.14):

Таблица 4.14 Итоговая стоимость

Статьи затрат на единицу изделия | Затраты на единицу изделия
Стоимость материалов | 178,94
Затраты на элементную базу | 7 633,2
Фонд оплаты труда | 23390,12
Амортизация оборудования | 163
Затраты на электроэнергии | 70,84
Всего: | 31436,1

## 6.8 Вывод по разделу

Благодаря проведённым расчётам мы можем увидеть, что именно влияет на стоимость готового изделия, реализуемого на рынке, а также в какой степени.

В нашем случае, более всего на себестоимость влияют такие статьи расходов, как:

- Материальные расходы;
- Оплата труда;

Материальные расходы, что в процентном соотношении от общей себестоимости готового изделия, составляют 71% и оплата труда, составляющую 23%. В сумме, дают 94% от себестоимости. Это говорит нам о том, что для уменьшения себестоимости изделия, в первую очередь необходимо рассматривать именно эти две статьи.

В случае с материальными расходами, большую часть от суммы этой статьи берут расходы на детали. А если быть более точными, то 98,99%. Уменьшить расходы по этой статье можно путём изменения конструкции и геометрических размеров деталей или выбором более дешёвых материалов, без потерь в качестве и прочности самих деталей, а также их функциональности.

В результате проведённой работе нам стало понятно, что именно необходимо скорректировать в затратах на наше изделие, для его наилучшего позиционирования на рынке.

# 5. ЭЛЕКТРИЧЕСКИЙ РАСЧЕТ

Последнее время очень широкого распространения получили полевые транзисторы. Основным достоинством полевого транзистора есть высокое входное сопротивление, которое может быть таким же, как и у электронных ламп, и даже больше.

В данной дипломной работе были рассчитаны основные электрические параметры полевого транзистора (сопротивление полностью открытого канала, напряжение отсечки, ёмкость затвора) и определена передаточная характеристика и связанные с нею параметры (начальный ток стока, напряжение насыщения).


Рисунок 5.1 - Принципиальная электрическая схема участка цепи

## 5.1 Расчёт параметров полевого транзистора с управляющим р-n переходом (рисунок 5.1.).

Задание на расчёт

ДАНО

1. Структура: полевой транзистор с управляющим р – п переходом на основе кремния с каналом п -типа электропроводности и двумя затворами (рисунок 5.2).

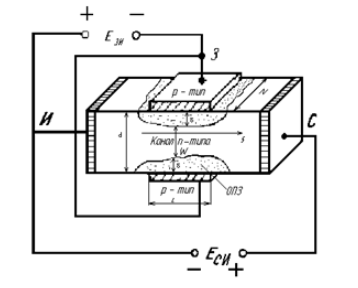
[picture p46: figure]

Рисунок 5.2 - Принципиальная электрическая схема участка цепи

2. Геометрические размеры канала: толщина d=1 мкм, ширина Z=500 мкм, длина L= 25 мкм.

3. Электрические параметры: концентрация донорной примеси в канале NД = 6•10¹⁵ см⁻³, концентрация акцепторной примеси в р - областях затворов Na=1•10¹⁸см⁻³.

ОПРЕДЕЛИТЬ

1. Основные электрические параметры: сопротивление полностью открытого канала RCИ отк, напряжение отсечки UЗИ отс, емкость затвора CЗИ, максимальную частоту роботы fmax.

2. Передаточную характеристику и связанные с нею параметры: начальный ток стока ICнач, напряжение насыщения UCИнас, крутизну характеристики передачи.

Порядок расчёта

1. Определяем основные электрические параметры.

(9)

2. Сопротивление полностью открытого канала при UЗИ = 0 и UСИ = 0 Находим, используя выражение удельное сопротивление исходного материала находим по заданной концентрации донорной примеси в канале с помощью графика (рисунок 5.3).

(2)


Рисунок 5.3. - Концентрации донорной примеси в канале силового P-канального транзистора SI2301DS

(10)

Напряжение отсечки определяем по формуле

(11)

где

(12)

(13)

- собственная концентрация носителей заряда. В кремнии собственная концентрация носителей заряда равна. - постоянная Больцмана1,38 • 10⁻²³ Дж •К-1 = 300 К - заряд електрона, = 1,6•10⁻¹⁹ Кл. Тогда будет равно

Диэлектрическая проницаемость кремния =12

Ёмкость затвора рассчитаем, как барьерную ёмкость р-п перехода при напряжении на затворе Uзи = 0 для резкого перехода, что справедливо в случае неглубокой диффузии, когда градиент концентрации примеси в р-п переходе велик, или в случае сплавной технологии образования затвора, получаем

(14)

Максимальную (рабочую) частоту можно найти по формуле

(15)

## 3.2 Расчёт передаточной характеристики начинают с определения начального тока стока с помощью соотношения

(16)

(17)

Передаточная характеристика на участке насыщения рассчитывается согласно выражению

(18)

Задавая значения UЗИ найдём значения IC

Таблица 5.1 Результаты 1

UЗИ, В | 1,5 | 1,4 | 1,3 | 1,2 | 1,1 | 1 | 0,9 | 0,8
IC, мА | 0,000000 | 0,000003 | 0,000012 | 0,000026 | 0,000046 | 0,000072 | 0,000104 | 0,000142
UЗИ, В | 0,7 | 0,6 | 0,5 | 0,4 | 0,3 | 0,2 | 0,1
IC, мА | 0,000185 | 0,000234 | 0,000289 | 0,000350 | 0,000416 | 0,000488 | 0,000566

(19)

Крутизну передаточной характеристики находим, подставив в выражение формулу

(20)

На участке насыщения в зависимости от тока стока получаем

Таблица 5.2 Результаты 2

IC, мА | 0 | 0,02 | 0,05 | 0,1 | 0,15 | 0,2 | 0,25 | 0,3
S, мА/В | 0 | 0,152019 | 0,240362 | 0,339924 | 0,41632 | 0,480725 | 0,537467 | 0,588765
IC, мА | 0,35 | 0,4 | 0,45 | 0,5 | 0,55 | 0,6 | 0,65 | 0,7
S, мА/В | 0,635939 | 0,679848 | 0,721087 | 0,760093 | 0,797192 | 0,83264 | 0,866639 | 0,899354

Задаваясь напряжением на затворе, находим напряжение насыщения между стоком и стоком с помощью выражения

(21)

Таблица 5.3 Результаты 3

UЗИ, В | 1,5 | 1,4 | 1,3 | 1,2 | 1,1 | 1 | 0,9 | 0,8
UСИ нас В | 0 | 0,1 | 0,2 | 0,3 | 0,4 | 0,5 | 0,6 | 0,7
UЗИ, В | 0,7 | 0,6 | 0,5 | 0,4 | 0,3 | 0,2 | 0,1 | 0,7
UСИ нас В | 0,8 | 0,9 | 1 | 1,1 | 1,2 | 1,3 | 1,4 | 0,8

## 3.3 Вывод по разделу

В результате проведённых расчетов основных электрических параметров полевого транзистора были получены следующие результаты:

Сопротивление полностью открытого канала RСИ отк, Напряжение отсечки UЗИ отс, емкость затвора СЗИ, максимальную частоту работы полевого транзистора, определена передаточная характеристика и связанные с нею параметры: начальный ток стока ICнач, напряжение насыщения UCИнас, крутизна характеристики передачи, нарисованы диаграммы.

# 6. ОХРАНА ТРУДА

## 6.1 Охрана окружающей среды

Правовую основу охраны окружающей среды в стране составляет закон РСФСР «О санитарно-эпидемиологическом благополучии населения» (1991). Требования охраны окружающей среды зафиксировано в Основах законодательства РФ «Об охране здоровья граждан» (1993) и в законе РФ «О защите прав потребителей» (1992).

Основным видом нормативно-правовых актов по охране окружающей среды является система стандартов “Охрана природы”, имеющая номер 17 и состоящая из 10 комплексов.

При использовании персональных компьютеров, требуют решения такие важные вопросы, как переработка отходов (платы, микросхемы с содержанием цветных металлов). При переработке устаревших компьютеров происходит их разборка на шесть составляющих компонентов: металлы, пластмассы, штекеры, провода, батареи, стекло. Для повторной эксплуатации нельзя использовать ни одну из отработанных деталей, так как нет гарантии ее надежности, но в форме вторичного сырья они используются при изготовлении новых компьютеров или каких-либо других устройств. Так же компоненты ПК содержат драгоценные металлы, которые извлекаются при вторичной переработке. Переработку компонентов с целью утилизации драг металлов регламентирует «Методика проведения работ по комплексной утилизации вторичных драгоценных металлов из отработанных средств вычислительной техники».

При эксплуатации ПК расходуются такие ресурсы, как электроэнергия (обеспечение питания компьютера), бумага, используемая для принтера при выводе информации, картриджи. Для того, чтобы добиться наиболее рациональных затрат электроэнергии не следует оставлять включенным персональный компьютер и оргтехнику, когда они не эксплуатируются в настоящее время, печать осуществлять с двух сторон, при этом затраты на бумагу вряд ли удастся сократить хотя бы вдвое, но экономия будет ощутимой. Проблему с утилизацией бумаги может решить вторичная переработка отходов.

На этапе прототипирования используются такие станки, как 3д-принтер и лазерный станок. Для очистки удаляемого воздуха от вредных примесей с участков лазерной резки, применяются фильтрующие модули с двухступенчатой очисткой воздуха: 1-ая ступень от твердой фазы загрязняющих веществ и 2-ая ступень угольные фильтры – от газообразной фазы. В дальнейшем в угольных картриджах меняется только сорбент: смесь неимпрегнированных и импрегнированных активированных углей. После того, как угольные фильтры перестают очищать воздух, сорбент сдается в специальные приемники, где подвергаются утилизации. Бракованные детали и обрезки, образовавшиеся в ходе лазерной резке, подлежат утилизации.

При 3д-печтаи используется АБС-пластик, который является токсичным. При работе с таким пластиком подразумевается его переработка или утилизация в спецприемниках. Эффективной технологической стадией переработки отходов АБС является сушка полимера, позволяющая довести содержание влаги в нем до уровня, не превышающего 0,1 %.

Однако способ прямого прессования оказывается малопроизводительным, а экструзия полимера затрудняется из-за его высокой вязкости.

Перспективной представляется переработка технологических отходов АБС- полимера методом литья под давлением. При этом для улучшения текучести полимера необходимо вводить технологические добавки. Добавка к полимеру облегчает процесс переработки АВС - полимера, так как приводит к увеличению подвижности макромолекул, гибкости полимера и снижению его вязкости. Бракованные и изношенные изделия можно утилизировать измельчением с последующим формованием полученной крошки в смеси с первичными материалами или в качестве самостоятельного сырья.

## 6.2 Защита в чрезвычайных ситуациях

На объект могут возникать чрезвычайные ситуации следующего характера:

- техногенные;
- экологические;
- природные.

Наиболее типичной ЧС для помещения, котором производится выполнение работы, является пожар. Данная ЧС может произойти в случае замыкания электропроводки оборудования, неправильная эксплуатация электроприборов и станков, не соблюдению мер пожаробезопасности и т.д.

Пожарная безопасность может быть обеспечена мерами пожарной профилактики и активной пожарной защиты. Пожарная профилактика включает комплекс мероприятий, направленных на предупреждение пожара или уменьшение его последствий. Активная пожарная защита–меры, обеспечивающие успешную борьбу с пожарами или взрывоопасной ситуацией. Возникновение пожара в помещении, где установлена вычислительная и оргтехника, приводит к большим материальным потерям и возникновению чрезвычайной ситуации. Чрезвычайные ситуации приводят к полной потере информации и большим трудностям восстановления всей информации в полном объёме.

Согласно нормам технологического проектирования, в зависимости от характеристики используемых в производстве веществ и их количества, по пожарной и взрывной опасности помещения подразделяются на категории А, Б, В, Г, Д.

Данное помещение относится к категории В, производства, связанные с обработкой или применением твердых сгораемых веществ и материалов.

Для исключения возникновения пожара необходимо:

- вовремя выявлять и устранять неисправности;
- не использовать открытые обогревательные приборы, приборы кустарного производства в помещении лаборатории;
- определить порядок и сроки прохождения противопожарного инструктажа и занятий по пожарно-техническому минимуму, а также назначить ответственного за их проведения.

В случае возникновения пожара необходимо отключить электропитание, вызвать по телефону пожарную команду, произвести эвакуацию и приступить к ликвидации пожара огнетушителями. При наличии небольшого очага пламени можно воспользоваться подручными средствами с целью прекращения доступа воздуха к объекту возгорания.

Для тушения пожаров в помещении необходимо установить углекислотный огнетушитель типа ОУ-5. Покидать помещение необходимо согласно плану эвакуации.

# 7. ТЕХНИКА БЕЗОПАСНОСТИ

С развитием научного прогресса безопасность жизнедеятельности человека играет огромную роль на производстве. В соответствии с требованиями безопасности была создана наука, которая помогает обеспечить безопасность жизнедеятельности человека (БЖД). БЖД – это комплекс мероприятий, направленных на обеспечение безопасности человека в окружающей его среде обитания, сохранение его здоровья, разработку методов и средств защиты путём снижения влияния вредных и опасных факторов до допустимых значений, выработку мер по ограничению ущерба в ликвидации последствий чрезвычайных ситуаций мирного и военного времени.

Научно-технический прогресс внес серьезные изменения в условия производственной деятельности работников умственного труда. Их труд стал более интенсивным, напряженным, требующим значительных затрат умственной, эмоциональной и физической энергии. Это потребовало комплексного решения проблем эргономики, гигиены и организации труда, регламентации режимов труда и отдыха.

С каждым годом возрастает интенсивность применения компьютерной техники в сферах жизнедеятельности человека. При работе с компьютером человек подвергается воздействию ряда опасных и вредных производственных факторов: электромагнитных полей, радиочастотному (высоких, ультравысоких и средних частот), инфракрасному излучению, шуму и вибрации, статическому электричеству. Работа с компьютером характеризуется значительным умственным напряжением, высокой напряженностью зрительной работы и большой нагрузкой на кисти рук при работе с периферийными устройствами ЭВМ.

Таблица 7.1 – Предельно допустимые значения энергетической экспозиции

| Предельно допустимая энергетическая экспозиция, МГц
Параметр | ≥ 0,03 − 3.0 | ≥ 3,0 − 30,0 | ≥ 30,0 − 50,0 | ≥ 50,0 − 300,0 | ≥ 300,0 − 300000,0
По электрической составляющей, (В/м)2 ×ч | 20000,0 | 7000,0 | 800 | 800 | -
По магнитной составляющей, (А/м)2× ч | 200 | - | 0,72 | - | -
По плотности потока энергии (мкВт/см2) × ч | - | - | - | - | 200

Для обеспечение меньшего электромагнитного излучение использован жидкокристаллический монитор. Необходимо учитывать расстояние до монитора, так как при большем расстоянии от человека оказывается меньшее влияние. В связи с тем, что электромагнитное излучение от стенок монитора намного больше, необходимо ограничивать его стенами, т.е. ставить в углу. Необходимо чтобы компьютер был заземлен, а также необходимо по возможности сокращать время работы за компьютером.

## 7.1 Выделение вредных веществ

В работе присутствует этап прототипирование, который основывается на создание деталей при помощи лазерного станка и 3D - принтера.

При работе 3D - принтера выделяются вредные вещества, которые не значительно влияют на здоровье человека. По ГН 2.2.5.1313–03 для акрилонитрила (C3H3N), которые входит в состав ABC-пластика:

- Величина предельно допустимая концентрация: 5 мг/м³;
- Преимущественное агрегатное состояние в воздухе в условиях производства: а – аэрозоль;
- Класс опасности: не опасное.

Так как величина предельно допустимой концентрации 5 мг/м³ для уменьшения концентрации можно провести вентиляцию над рабочей зоной или периодически проветривать помещение.

При нагревании и испарении пластиков в процессе лазерной резки возникают вредные вещества в виде мельчайших твердых частиц размером от 0,03мкм и газообразные едкие и токсичные вещества: хлористый водород, диоксины, угарный газ, окись и двуокись азота, уксусный альдегид, метилметакрилат, винилхлорид, смесь углеводородов, стирол.

Смесь вышеперечисленных мельчайших частиц с газообразными токсичными веществами представляют максимальную опасность для операторов и персонала. Накапливаясь в организме человека, они могут вызвать тяжелейшие заболевания, в том числе онкологические.

В связи с этим лазерная резка пластика должна производится в помещении местной вытяжкой с очисткой удаляемого воздуха от вредных твердых и газообразных веществ и с использованием средств индивидуальной защиты.

В офисе имеется искусственная вентиляция, состоящая из вытяжной и приточной вентиляции, что позволяет производить циркуляцию воздуха в помещение при лазерной резке и 3D-печати.

## 7.2 Электробезопасность

Даже самая надежная изоляция теряет свои свойства при длительной эксплуатации в сложных производственных условиях. Опасность поражения электрическим током существенно возрастает, если человек находится в помещении с металлическим полом или контактирует с оборудованием, находящихся вблизи заземленных металлических предметов.

Первый класс - "помещения без повышенной опасности"

В данную категорию входят помещения, характеризующиеся пониженной влажностью воздуха (до 75%), оборудованные при необходимости вентиляционной системой и отоплением.

Кроме того, полы в таких помещениях должны быть не токопроводящими. Под понятием токопроводящие полы подразумевают металлические, железобетонные, земляные и т.д. Для причисления производственного цеха в разряд безопасных, его пол следует покрыть диэлектрическим материалом. К наглядным примерам безопасных объектов можно отнести обычные жилые и офисные помещения, кладовые для хранения инструментов, лаборатории, а также производственные цеха приборостроительных предприятий, проект которых изначально предусматривал наличие изолированного пола, мощные воздушные фильтры для устранения пыли и систему регулирования температуры воздуха.

В зависимости от условий в помещении опасность поражения человека электрическим током увеличивается или уменьшается. По помещение, в котором находится рабочее место, относится к категории помещений без повышенной опасности. Его можно охарактеризовать, как сухое, непыльное, с токо непроводящими полами и нормальной температурой воздуха. Температурный режим, влажность воздуха, химическая среда не способствуют разрушению изоляции электрооборудования.

Безопасность при работе с электроустановками обеспечивается применением различных технических и организационных мер. Основные технические средства защиты от поражения электрическим током:

- изоляция токопроводящих частей и ее непрерывный контроль;
- установка оградительных устройств;
- предупредительная сигнализация и блокировки;
- защитное заземление;

# ЗАКЛЮЧЕНИЕ

В период с 22 апреля по 18 мая 2024 года, я проходил производственную практику на заводе «ООО «Эйдос»».

В ходе практики мне удалось проследить связь теоретических знаний с практической деятельностью.

Оказалось, что работа на предприятие - очень сложный процесс, требующий неукоснительного соблюдения правил. На все возникающие вопросы на практики, мне ответил руководитель Салахов А.Р.

Я приобрёл незаменимый опыт, который мне очень пригодится в дальнейшей профессиональной деятельности.

Во время прохождения практики отметил, следующие положительные моменты:

1) Чистота цехов

2) Соблюдение правил труда и безопасности
3) К работе допускаются только те, кто прошел инструктаж
4) Отходы из цехов удаляются своевременно
5) Цеха оснащены всеми необходимыми оборудованиями и инструментами

# СПИСОК ИСПОЛЬЗУЕМЫХ ИСТОЧНИКОВ

1. Подураев, Ю.В. Мехатроника: основы, методы, применение: учеб. пособие для студентов вузов / Ю.В. Подураев. – М.: Машиностроение, 2006. – 256 с.
2. Сычков В.Б. Диссертация на соискание ученой степени кандидата технических наук "Методы и алгоритмы обработки информации для повышения точности выполнения целевых операций при копирующем управлении манипуляторами антропоморфного робота" Ставрополь – 2019
3. Теряев, Е.Д. Современный этап развития мехатроники и грядущая конвергенция с нанотехнологиями / Е.Д. Теряев, Н.Б. Филимонов, К.В. Петрин // Мехатроника, автоматизация, управление: материалы II Российской конференции по проблемам управления. – СПб.: Изд-во ГНЦ РФ ЦНИИ «Электроприбор», 2008. – С. 9-21.
4. ГОСТ Р 60.0.7.1-2016. Роботы и робототехнические устройства. Методы программирования и взаимодействия с оператором. – Введ. 2018-01-01.– М.: Стандартинформ, 2016. – 11 с.
5. ГОСТ Р 50936 от 2013г «Ремонт, установка и техническое обслуживание радиоэлектронной аппаратуры»
6. Постановление Правительства РФ от 25.04.2012 N 390 (ред. От 30.12.2017) "О противопожарном режиме" (вместе с "Правилами противопожарного режима в Российской Федерации")
7. СанПиН 2.2.1/2.1.1.1278 – 03. «Гигиенические требования к естественному, искусственному и совмещённому освещению жилых и общественных зданий.» М.: Минздрав России, 2003.
8. СанПиН 2.2.4.3359-16 – Санитарно-эпидемиологические требования к физическим факторам на рабочих местах: утв. постановлением Главного государственного санитарного врача РФ от 21.06.2016 № 81
9. СанПиН 2.2.2/2.4.1340 – 03. Санитарно-эпидемиологические правила и нормативы «Гигиенические требования к персональным электронно- вычислительным машинам и организации работы». – М.: Госкомсанэпиднадзор, 2003.

Интернет источники

10. https://eidos-medicine.com/ ДОБРО ПОЖАЛОВАТЬ В EIDOS (Дата обращения 13.04.24)
11. https://microkontroller.ru/esp32-projects/ispolzovanie-bluetooth-v-module-esp32/ Использование Bluetooth в модуле ESP32 (Дата обращения 18.08.24)
12. https://ru.wikipedia.org/wiki/ESP32 ESP32 (Дата обращения 16.05.24)
13. https://ru.wikiversity.org/wiki/Устройства_управления_мехатронных_систем/роботов Устройства управления мехатронных систем/роботов (Дата обращения 11.05.24)
14. https://studref.com/650471/tehnika/protsess_kontrolya Процесс контроля (Дата обращения 13.04.24)
15. https://studbooks.net/2466306/prochie_distsipliny/osnovnye_pravila_ekspluatatsii_elektronnoy_apparatury ОСНОВНЫЕ ПРАВИЛА ЭКСПЛУАТАЦИИ ЭЛЕКТРОННОЙ АППАРАТУРЫ (Дата обращения 13.04.24)
16. https://studfile.net/preview/1427154/ Определение электронных приборов. Классификация электронных приборов (Дата обращения 13.04.24)
17. https://wch-ic.com/products/CH340.html Микросхема USB-последовательного порта CH340 (Дата обращения 17.05.24)
18. https://studfile.net/preview/5336409/ Техническое обслуживание — мероприятия профилактического характера, проводимые систематически, принудительно через установленные периоды, включающие определённый комплекс работ. (дата обращения 13.04.24)
19. https://studfile.net/preview/8852340/page:29/ Контрольно-измерительная аппаратура для измерения побочных электромагнитных излучений и наводок. (дата обращения 13.04.24)
20. https://work.zabgu.ru/faculties_dis/GF/RGz_17/Метрология%20и%20стандартизация/Лекция%204.pdf Лекция 4. СРЕДСТВА ИЗМЕРЕНИЙ (дата обращения 13.04.24)

Инв. № подп Подп. и дата Взам. инв. № Инв. № дубл. Подп. и дата Лит Лист Листов 2 59 ГАПОУ «КРМК» гр. ЭП-460 Отчет по преддипломной практике ПДП .03.11.02.14.460.26.2 № докум. Изм. Подп. Дата Шамсиев М. А. Разраб. Беляев С. А. Пров. Рецензент Н. контр. Утв.

Инв. № подп Подп. и дата Взам. инв. № Инв. № дубл. Подп. и дата Лист 31 ПДП .03.11.02.14.460.26.24 Лит № докум. Изм. Подп. Дата
