Umayva/Diplom/курсовая/Schematic_New-Project_2024-02-09 (2).png

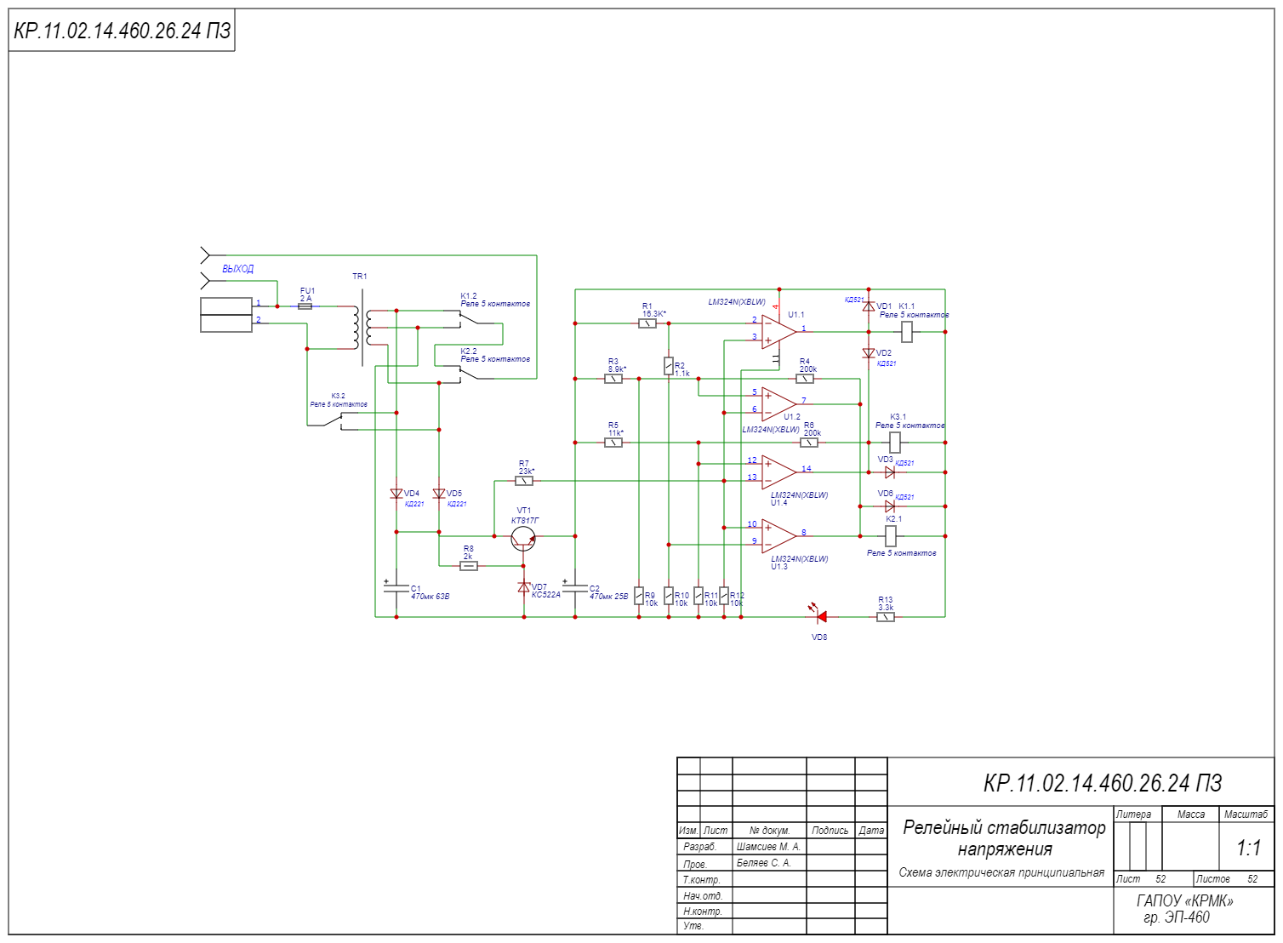
курсовая/Schematic_New-Project_2024-02-09 (2).png
