Umayva/Diplom/спецификация.xlsx

наименование | партия | цена за деталь | количесво/вес | цена | цена на изделие | партия | цена за деталь | количесво/вес | цена с ндс | цена на изделие | #DIV/0!
печатная плата jlcpcb 5шт | 5 | 298.2 ₽ | 1 | 1491.0 ₽ | 298.2 ₽ | 5 | 357.8 ₽ | 1 | 1789.2 ₽ | 357.8 ₽
Датчик давления FSR400 | 1 | 156.0 ₽ | 5 | 156.0 ₽ | 780.0 ₽ | 1 | 187.2 ₽ | 5 | 187.2 ₽ | 936.0 ₽
Сервопривод sg90 5шт | 5 | 201.4 ₽ | 5 | 1007.0 ₽ | 1007.0 ₽ | 5 | 241.7 ₽ | 5 | 1208.4 ₽ | 1208.4 ₽
Шлейф 1.2мм 9жил 2м | 2 | 93.0 ₽ | 1.5 | 186.0 ₽ | 139.5 ₽ | 2 | 111.6 ₽ | 1.5 | 223.2 ₽ | 167.4 ₽
Винт с шестигранной головкой ISO7380 М2,5х16 | 50 | 3.0 ₽ | 5 | 151.0 ₽ | 15.1 ₽ | 50 | 3.6 ₽ | 5 | 181.2 ₽ | 18.1 ₽
Винт с шестигранной головкой ISO7380 М2х10 | 50 | 2.4 ₽ | 5 | 118.0 ₽ | 11.8 ₽ | 50 | 2.8 ₽ | 5 | 141.6 ₽ | 14.2 ₽
3x4x6 Низкопрофильный прецизионный плечевой винт из нержавеющей стали 18-8 | 1 | 285.9 ₽ | 1 | 285.9 ₽ | 285.9 ₽ | 1 | 343.1 ₽ | 1 | 343.1 ₽ | 343.1 ₽
3x4x4 Низкопрофильный прецизионный плечевой винт из нержавеющей стали 18-8 | 1 | 228.4 ₽ | 4 | 228.4 ₽ | 913.6 ₽ | 1 | 274.1 ₽ | 4 | 274.1 ₽ | 1096.3 ₽
3x4x16 Низкопрофильный прецизионный плечевой винт из нержавеющей стали 18-8 | 1 | 285.9 ₽ | 1 | 285.9 ₽ | 285.9 ₽ | 1 | 343.1 ₽ | 1 | 343.1 ₽ | 343.1 ₽
Плоский вибромотор BVM 1027 10мм 3В для Arduino проектов CT Retail | 1 | 150.0 ₽ | 1 | 150.0 ₽ | 150.0 ₽ | 1 | 180.0 ₽ | 1 | 180.0 ₽ | 180.0 ₽
микроконторллер Wi-Fi ESP WROOM 32 | 1 | 260.0 ₽ | 1 | 260.0 ₽ | 260.0 ₽ | 1 | 312.0 ₽ | 1 | 312.0 ₽ | 312.0 ₽
CH340C, Преобразователь интерфейса USB в UART [SOP-16] | 1 | 99.0 ₽ | 1 | 99.0 ₽ | 99.0 ₽ | 1 | 118.8 ₽ | 1 | 118.8 ₽ | 118.8 ₽
USBLC6-2SC6, Защита интерфейса USB от электростатических разрядов [SOT-23-6] | 1 | 25.0 ₽ | 1 | 25.0 ₽ | 25.0 ₽ | 1 | 30.0 ₽ | 1 | 30.0 ₽ | 30.0 ₽
LM7805Стабилизатор напряжения, линейный,нерегулируемый, 5В, 2,2А | 1 | 200.0 ₽ | 1 | 200.0 ₽ | 200.0 ₽ | 1 | 240.0 ₽ | 1 | 240.0 ₽ | 240.0 ₽
AMS1117-3,3, Линейный регулятор с малым падением напряжения, 1А, 3,3В [SOT-223] | 1 | 9.0 ₽ | 2 | 9.0 ₽ | 18.0 ₽ | 1 | 10.8 ₽ | 2 | 10.8 ₽ | 21.6 ₽
2N7000, Транзистор, N-канал, 60В, 0.2А [TO-92] | 1 | 7.0 ₽ | 1 | 7.0 ₽ | 7.0 ₽ | 1 | 8.4 ₽ | 1 | 8.4 ₽ | 8.4 ₽
1N4148W, Диод 100В 0.15А [SOD-123] | 1 | 3.0 ₽ | 1 | 3.0 ₽ | 3.0 ₽ | 1 | 3.6 ₽ | 1 | 3.6 ₽ | 3.6 ₽
B5819WS, Диод Шоттки 40В 1А [SOD-323] | 1 | 4.0 ₽ | 1 | 4.0 ₽ | 4.0 ₽ | 1 | 4.8 ₽ | 1 | 4.8 ₽ | 4.8 ₽
GNL-0805SRC, Светодиод красный SMD 0603 9-15мКд 120° 660нМ | 1 | 12.0 ₽ | 1 | 12.0 ₽ | 12.0 ₽ | 1 | 14.4 ₽ | 1 | 14.4 ₽ | 14.4 ₽
GNL-0805GC, Светодиод зеленый SMD 0603 7-12мКд 120° 567нМ | 1 | 12.0 ₽ | 1 | 12.0 ₽ | 12.0 ₽ | 1 | 14.4 ₽ | 1 | 14.4 ₽ | 14.4 ₽
S8050, Транзистор NPN 25В 0.5А HFE=120…400 0.3Вт [SOT-23-3] | 1 | 4.0 ₽ | 2 | 4.0 ₽ | 8.0 ₽ | 1 | 4.8 ₽ | 2 | 4.8 ₽ | 9.6 ₽
Конденсатор керамический smd 10 мкФ X5R 16В 10% 0805 | 1 | 7.0 ₽ | 7 | 7.0 ₽ | 49.0 ₽ | 1 | 7.0 ₽ | 7 | 8.4 ₽ | 58.8 ₽
0,1мкф X7R 100в 10% (0805) Чип керам,конденсатор TCC0805X7R104K101FT | 1 | 2.0 ₽ | 13 | 2.0 ₽ | 26.0 ₽ | 1 | 2.4 ₽ | 13 | 2.4 ₽ | 31.2 ₽
RT0805BRD07100KL, (чип 0805 100К 0.1% +25ppm/°C), Тонкопленочный ЧИП-резистор 0805 100кОм +0.1% 0.125Вт -55°С...+155°С | 1 | 6.0 ₽ | 5 | 6.0 ₽ | 30.0 ₽ | 1 | 7.2 ₽ | 5 | 7.2 ₽ | 36.0 ₽
RS-05K202JT, ЧИП-резистор 0805 2кОм ±5% 0.125Вт -55°C...+155°C | 1 | 3.0 ₽ | 2 | 3.0 ₽ | 6.0 ₽ | 1 | 3.6 ₽ | 2 | 3.6 ₽ | 7.2 ₽
Резистор постоянный SMD 0805 10K 0.5% / RT0805DRE0710KL | 1 | 2.0 ₽ | 4 | 2.0 ₽ | 8.0 ₽ | 1 | 2.4 ₽ | 4 | 2.4 ₽ | 9.6 ₽
0.125Вт 0805 470 Ом, 1%, Чип резистор (SMD) | 1 | 4.0 ₽ | 2 | 4.0 ₽ | 8.0 ₽ | 1 | 4.8 ₽ | 2 | 4.8 ₽ | 9.6 ₽
1437566-3 (FSMSM), Кнопка тактовая h=4.6 мм SMD SPST | 1 | 45.0 ₽ | 2 | 45.0 ₽ | 90.0 ₽ | 1 | 54.0 ₽ | 2 | 54.0 ₽ | 108.0 ₽
47346-0001, Разъем micro USB-B | 1 | 140.0 ₽ | 1 | 140.0 ₽ | 140.0 ₽ | 1 | 168.0 ₽ | 1 | 168.0 ₽ | 168.0 ₽
XT30PW-M, Разъем питания штекер на плату угловой 2pin | 1 | 180.0 ₽ | 1 | 180.0 ₽ | 180.0 ₽ | 1 | 216.0 ₽ | 1 | 216.0 ₽ | 216.0 ₽
XT30U-F, Вилка питания DC XT30 "мама" провод под пайку Цвет желтый | 1 | 140.0 ₽ | 1 | 140.0 ₽ | 140.0 ₽ | 1 | 168.0 ₽ | 1 | 168.0 ₽ | 168.0 ₽
Плата модуля питания TP5100 для управления зарядкой | 1 | 43.0 ₽ | 1 | 43.0 ₽ | 43.0 ₽ | 1 | 51.6 ₽ | 1 | 51.6 ₽ | 51.6 ₽
Аккумулятор li-ion, 3000 мАч, 5 шт | 5 | 197.4 ₽ | 2 | 987.0 ₽ | 394.8 ₽ | 5 | 236.9 ₽ | 2 | 1184.4 ₽ | 473.8 ₽
Батарейный отсек для аккумуляторов 2 x 18650 Li-ion с проводами | 1 | 133.0 ₽ | 1 | 133.0 ₽ | 133.0 ₽ | 1 | 159.6 ₽ | 1 | 159.6 ₽ | 159.6 ₽
Стяжки на липучке, ремешок фиксатор 5шт. | 5 | 92.0 ₽ | 2 | 460.0 ₽ | 184.0 ₽ | 5 | 110.4 ₽ | 2 | 552.0 ₽ | 220.8 ₽
Защитные накладки на кончики пальцев для гитары 10 шт | 10 | 35.9 ₽ | 5 | 359.0 ₽ | 179.5 ₽ | 10 | 43.1 ₽ | 5 | 430.8 ₽ | 215.4 ₽
Пластик для 3D принтера PLA Geekfilament 1.75мм, | 1000 | 1.1 ₽ | 200 | 1073.0 ₽ | 214.6 ₽ | 1000 | 1.3 ₽ | 200 | 1287.6 ₽ | 257.5 ₽
6361.00 ₽ |  |  |  |  |  |  |  |  |  | 7633.2 ₽
Ноутбук Honor MagicBook 14 5301AFLS, 14", IPS, AMD Ryzen 5 5500U 2.1ГГц, 6-ядерный, 8ГБ DDR4, 512ГБ SSD, AMD Radeon, Windows 11 Home, серый | 1 | 43990.0 ₽ | 1 | 43990.0 ₽ | 43990.0 ₽
3D-принтер Flying Bear Ghost 5, | 1 | 21863.3 ₽ | 1 | 21863.3 ₽ | 21863.3 ₽ |  |  |  |  | 15266.4 ₽
Термовоздушная паяльная станция МЕГЕОН 00550 к0000020550 | 1 | 13566.0 ₽ | 1 | 13566.0 ₽ | 13566.0 ₽
Прямошлифовальная машинка Ryobi EHT150V 5133000754 | 1 | 5554.0 ₽ | 1 | 5554.0 ₽ | 5554.0 ₽
Набор отверток из стали S2 КВТ Мастер НО-06-S 78622 | 1 | 729.0 ₽ | 1 | 729.0 ₽ | 729.0 ₽
JIMI JM-GNT80 80 в 1 прецизионные отвертки многофункциональные DIY ремонт отвертки S2 Биты из легированной стали с 2 стержнями | 1 | 3398.0 ₽ | 1 | 3398.0 ₽ | 3398.0 ₽
Автоматический цифровой мультиметр Вымпел VC835 5228 | 1 | 2231.0 ₽ | 1 | 2231.0 ₽ | 2231.0 ₽
Набор шарнирно-губцевого инструмента Tactix Ergo 204025, 5 предм. | 1 | 3623.0 ₽ | 1 | 3623.0 ₽ | 3623.0 ₽
Источник питания VERDO PP1106 60 В, 10А, 300 Вт PP110600 | 1 | 21650.0 ₽ | 1 | 21650.0 ₽ | 21650.0 ₽
94954.3 ₽
