Umayva/Diplom/чертежи/Модели/корпус/Right Hand/Print as is/Новая папка/печать/R Lower Mainl.stl

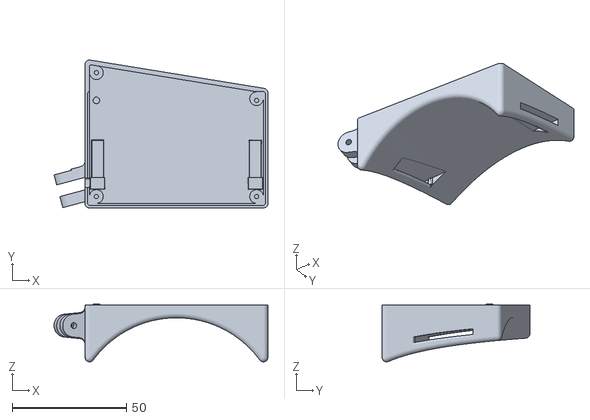
[picture p48: CAD file, 2024-06-10]
чертежи/Модели/корпус/Right Hand/Print as is/Новая папка/печать/R Lower Mainl.stl
93.5 x 64.6 x 25.3
