Umayva/Diplom/espressif-altium-libs-main/espressif-altium-libs-main/Models/ESP32-C3/ESP32-C3-MINI-1.STEP

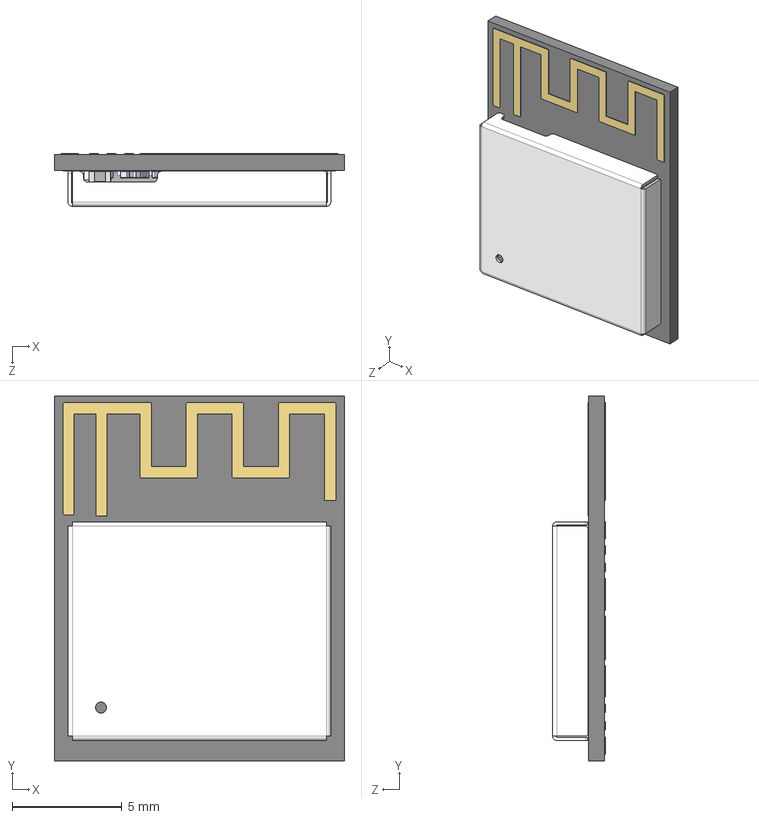
[picture p49: CAD file, 2023-12-14]
espressif-altium-libs-main/espressif-altium-libs-main/Models/ESP32-C3/ESP32-C3-MINI-1.STEP
13.2 x 16.6 x 2.40 mm
DFN1006.STEP(2)^DFN1006.STEP(2)_Submodel-SOD882_part(2)_DesignRootModel(2)_PCB_ESP32-C3-MINI-1_V1A(2)_PCB_ESP32-C3-MINI-1_V1A
R0201_20210301.STEP(2)^R0201_20210301.STEP(2)_Submodel-R0201_part(2)_DesignRootModel(2)_PCB_ESP32-C3-MINI-1_V1A(2)_PCB_ESP32-C3-MINI-1_V1A x 3
placementOutline(2)^Submodel-noModelForPart_MINI-ANT-TYPED-H_1968823293(2)_Submodel-MINI-ANT-TYPED-H_1968823293_part(2)_DesignRootModel(2)_PCB_ESP32-C3-MINI-1_V
placementOutline-0(2)^Submodel-noModelForPart_MINI-ANT-TYPED-H_1968823293(2)_Submodel-MINI-ANT-TYPED-H_1968823293_part(2)_DesignRootModel(2)_PCB_ESP32-C3-MINI-1
placementOutline-1(2)^Submodel-noModelForPart_MINI-ANT-TYPED-H_1968823293(2)_Submodel-MINI-ANT-TYPED-H_1968823293_part(2)_DesignRootModel(2)_PCB_ESP32-C3-MINI-1
placementOutline-2(2)^Submodel-noModelForPart_MINI-ANT-TYPED-H_1968823293(2)_Submodel-MINI-ANT-TYPED-H_1968823293_part(2)_DesignRootModel(2)_PCB_ESP32-C3-MINI-1
placementOutline-3(2)^Submodel-noModelForPart_MINI-ANT-TYPED-H_1968823293(2)_Submodel-MINI-ANT-TYPED-H_1968823293_part(2)_DesignRootModel(2)_PCB_ESP32-C3-MINI-1
placementOutline-4(2)^Submodel-noModelForPart_MINI-ANT-TYPED-H_1968823293(2)_Submodel-MINI-ANT-TYPED-H_1968823293_part(2)_DesignRootModel(2)_PCB_ESP32-C3-MINI-1
placementOutline-5(2)^Submodel-noModelForPart_MINI-ANT-TYPED-H_1968823293(2)_Submodel-MINI-ANT-TYPED-H_1968823293_part(2)_DesignRootModel(2)_PCB_ESP32-C3-MINI-1
trace_4(2)^Submodel-MINI-ANT-TYPED-H_1968823293_part(2)_DesignRootModel(2)_PCB_ESP32-C3-MINI-1_V1A(2)_PCB_ESP32-C3-MINI-1_V1A
trace_1(2)^Submodel-MINI-ANT-TYPED-H_1968823293_part(2)_DesignRootModel(2)_PCB_ESP32-C3-MINI-1_V1A(2)_PCB_ESP32-C3-MINI-1_V1A
C0402_20210301.STEP(2)^C0402_20210301.STEP(2)_Submodel-C0402_part(2)_DesignRootModel(2)_PCB_ESP32-C3-MINI-1_V1A(2)_PCB_ESP32-C3-MINI-1_V1A
C0201_20210301.STEP(2)^C0201_20210301.STEP(2)_Submodel-C0201_part(2)_DesignRootModel(2)_PCB_ESP32-C3-MINI-1_V1A(2)_PCB_ESP32-C3-MINI-1_V1A x 11
L0201_20210301.STEP(2)^L0201_20210301.STEP(2)_Submodel-L0201_part(2)_DesignRootModel(2)_PCB_ESP32-C3-MINI-1_V1A(2)_PCB_ESP32-C3-MINI-1_V1A x 2
XTAL3225_20210301.STEP(2)^XTAL3225_20210301.STEP(2)_Submodel-XTAL3225_part(2)_DesignRootModel(2)_PCB_ESP32-C3-MINI-1_V1A(2)_PCB_ESP32-C3-MINI-1_V1A
ESP32-C3_20210301.STEP(2)^ESP32-C3_20210301.STEP(2)_Submodel-QFN32_0P5_5_part(2)_DesignRootModel(2)_PCB_ESP32-C3-MINI-1_V1A(2)_PCB_ESP32-C3-MINI-1_V1A
uid__2428(2)^DesignRootModel(2)_PCB_ESP32-C3-MINI-1_V1A(2)_PCB_ESP32-C3-MINI-1_V1A
ShieldBox_ESP32-C3-MINI-1_V1.0_20200901
solder_pad
