Umayva/Diplom/espressif-altium-libs-main/espressif-altium-libs-main/Models/ESP32-S2/ESP32-S2-WROVER.STEP

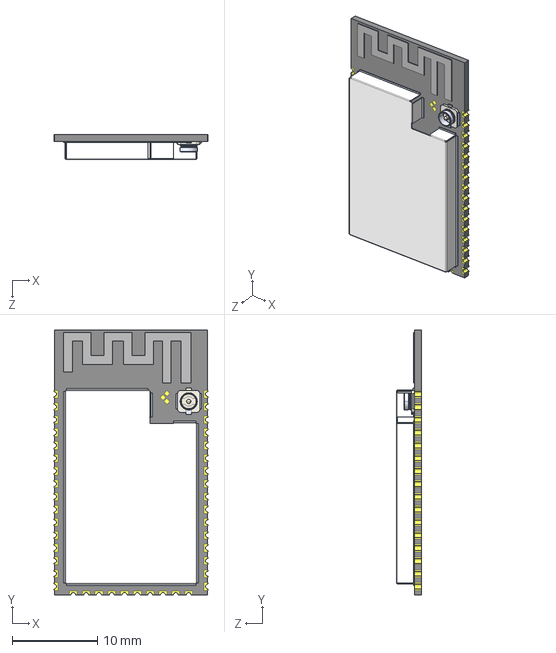
[picture p50: CAD file, 2023-12-14]
espressif-altium-libs-main/espressif-altium-libs-main/Models/ESP32-S2/ESP32-S2-WROVER.STEP
18.0 x 31.0 x 2.91 mm
