Umayva/Diplom/espressif-altium-libs-main/espressif-altium-libs-main/Models/ESP8266-01S.step

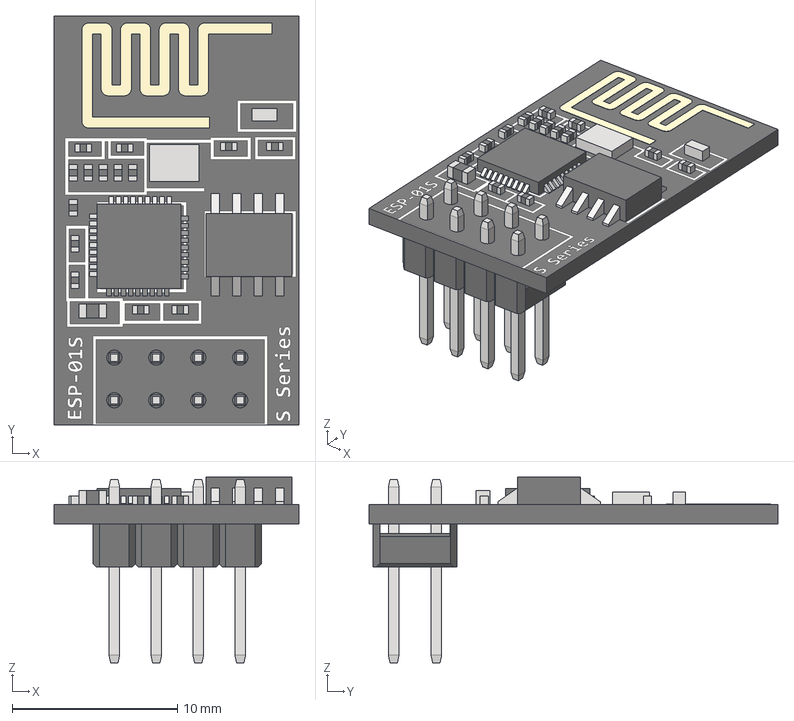
[picture p51: CAD file, 2023-12-14]
espressif-altium-libs-main/espressif-altium-libs-main/Models/ESP8266-01S.step
14.8 x 24.8 x 11.2 mm
PCB
Antenna
SerialFlashMem
ESP8266EX
Male Pin Header 2x4
SmalComponent x 14
LargeComponent
LED
Crystal
