Umayva/Diplom/чертежи/Модели/sot23-6.step

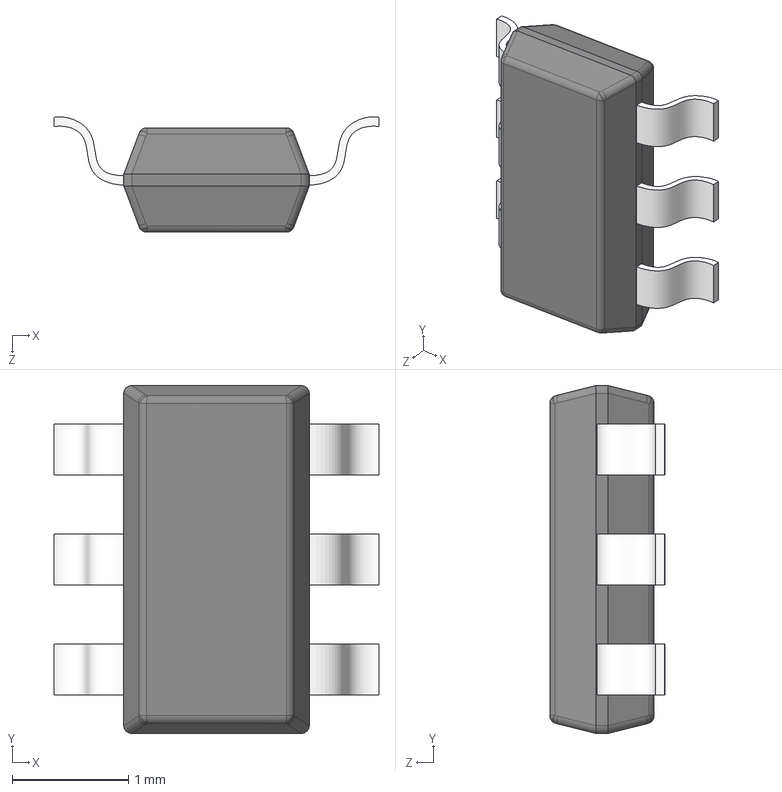
[picture p52: CAD file, 2024-06-10]
чертежи/Модели/sot23-6.step
2.80 x 3.00 x 0.995 mm
sot23-6
sot23-6_001
