Umayva/Diplom/чертежи/Модели/корпус/Right Hand/Print as is/Новая папка/печать/1_Thumb Spring Cap.stl

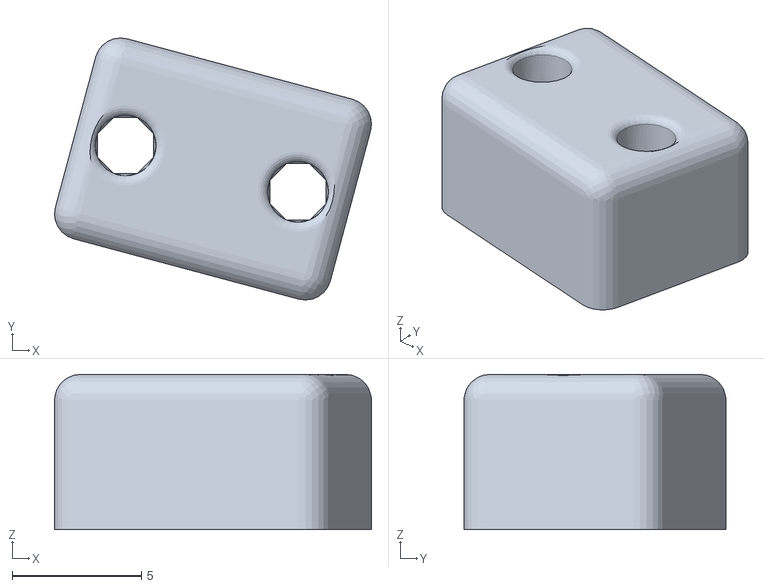
[picture p53: CAD file, 2024-06-10]
чертежи/Модели/корпус/Right Hand/Print as is/Новая папка/печать/1_Thumb Spring Cap.stl
12.2 x 10.1 x 6.00
