Umayva/Diplom/espressif-altium-libs-main/espressif-altium-libs-main/Models/ESP32-S3-QFN56-77-44.STEP

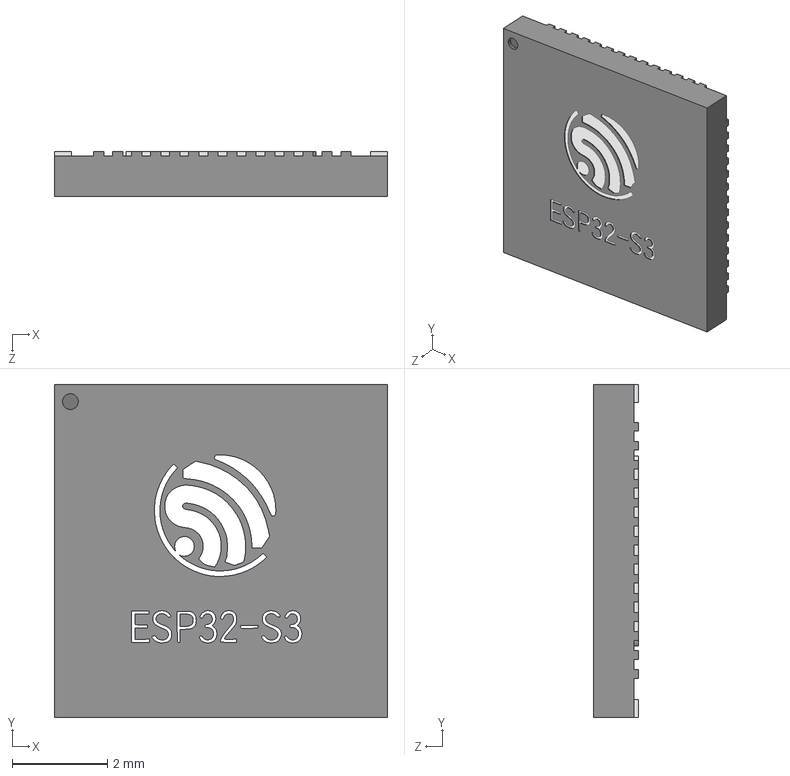
[picture p54: CAD file, 2023-12-14]
espressif-altium-libs-main/espressif-altium-libs-main/Models/ESP32-S3-QFN56-77-44.STEP
7.00 x 7.00 x 0.95 mm
