Umayva/Diplom/чертежи/Модели/корпус/Right Hand/Print as is/Новая папка/печать/L_FingerServ.stl

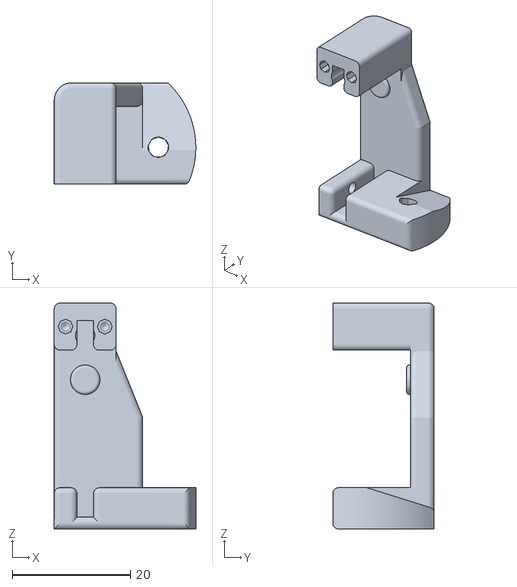
[picture p55: CAD file, 2024-06-10]
чертежи/Модели/корпус/Right Hand/Print as is/Новая папка/печать/L_FingerServ.stl
24.0 x 17.2 x 38.3
