Umayva/Diplom/espressif-altium-libs-main/espressif-altium-libs-main/Models/ESP32-S3-WROOM.step

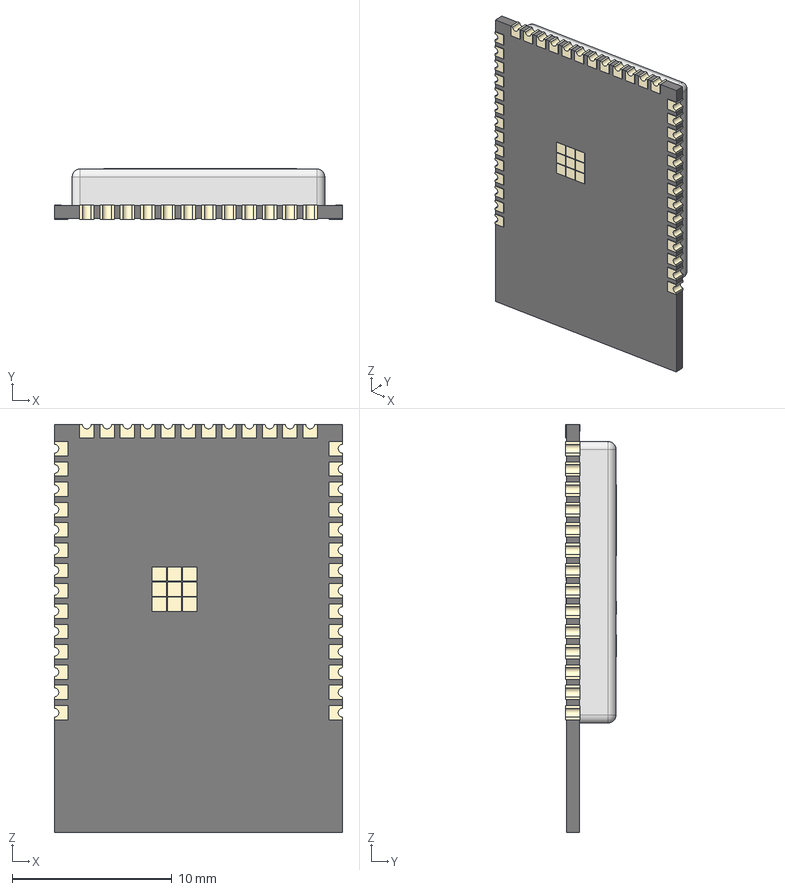
[picture p56: CAD file, 2023-12-14]
espressif-altium-libs-main/espressif-altium-libs-main/Models/ESP32-S3-WROOM.step
18.0 x 3.16 x 25.5 mm
ESP-S3-WROOM_via x 26
ESP32-S3-WROOM_shell
ESP32-S3-WROOM_body
ESP-S3-WROOM_via v3(镜像) x 14
