Umayva/Diplom/чертежи/Модели/корпус/Right Hand/Print as is/Новая папка/печать/UPPER.stl

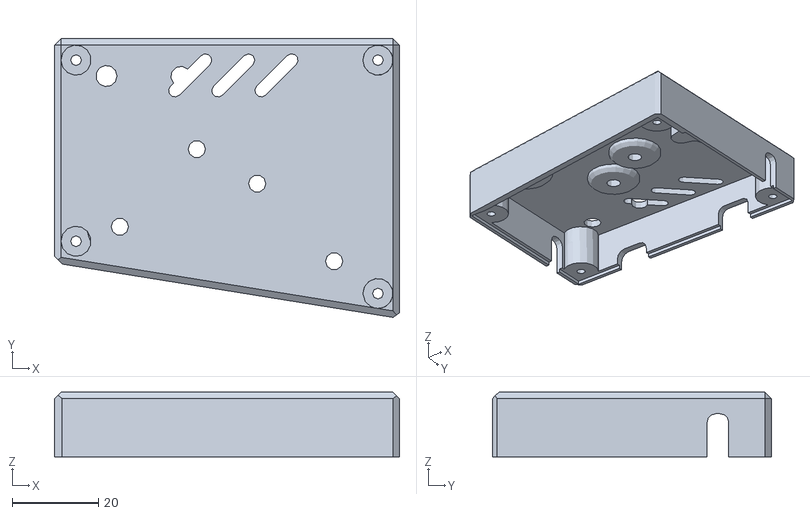
[picture p57: CAD file, 2024-06-10]
чертежи/Модели/корпус/Right Hand/Print as is/Новая папка/печать/UPPER.stl
80.0 x 64.7 x 15.0
