Umayva/Diplom/чертежи/Модели/корпус/Right Hand/Print as is/Новая папка/печать/кость сокет.stl

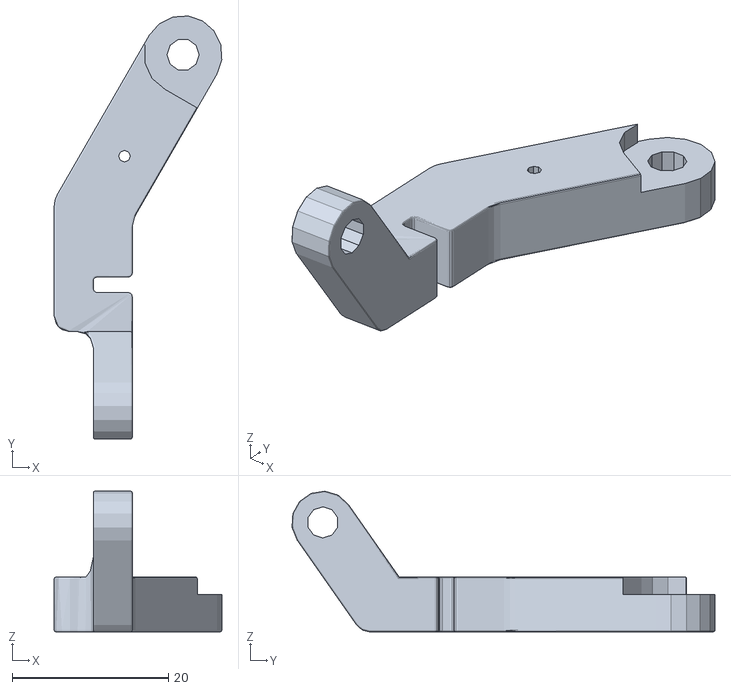
[picture p58: CAD file, 2024-06-10]
чертежи/Модели/корпус/Right Hand/Print as is/Новая папка/печать/кость сокет.stl
21.5 x 54.2 x 18.0
