Umayva/Diplom/чертежи/Модели/корпус/Right Hand/Print as is/Новая папка/печать/4_Finger Spring Cap.stl

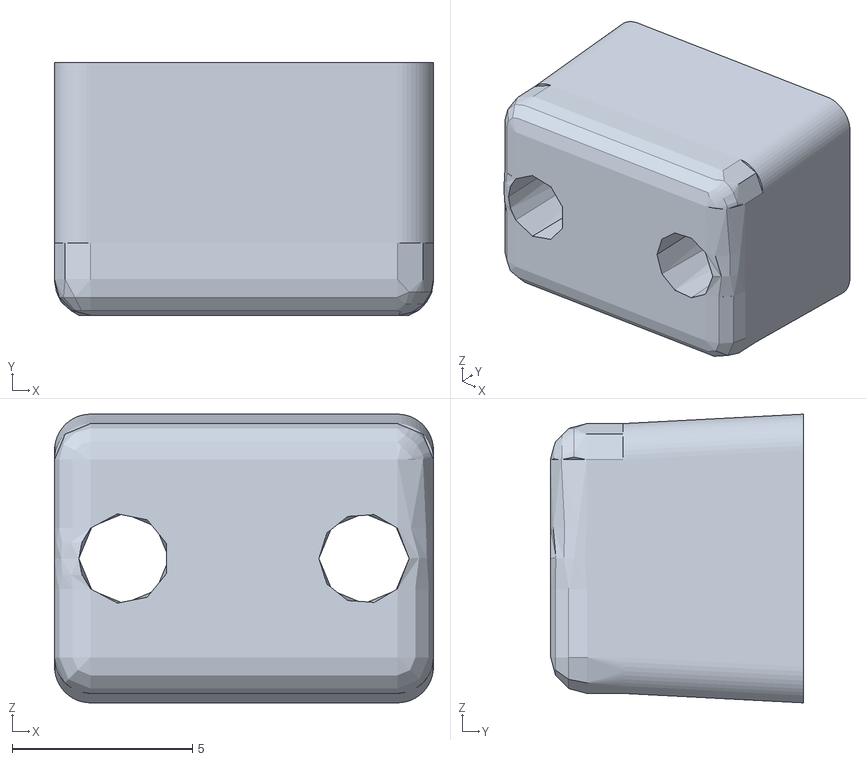
[picture p59: CAD file, 2024-06-10]
чертежи/Модели/корпус/Right Hand/Print as is/Новая папка/печать/4_Finger Spring Cap.stl
10.5 x 7.00 x 8.00
