Umayva/Diplom/чертежи/Модели/корпус/Right Hand/Print as is/Новая папка/печать/R Thumb servo bracket.stl

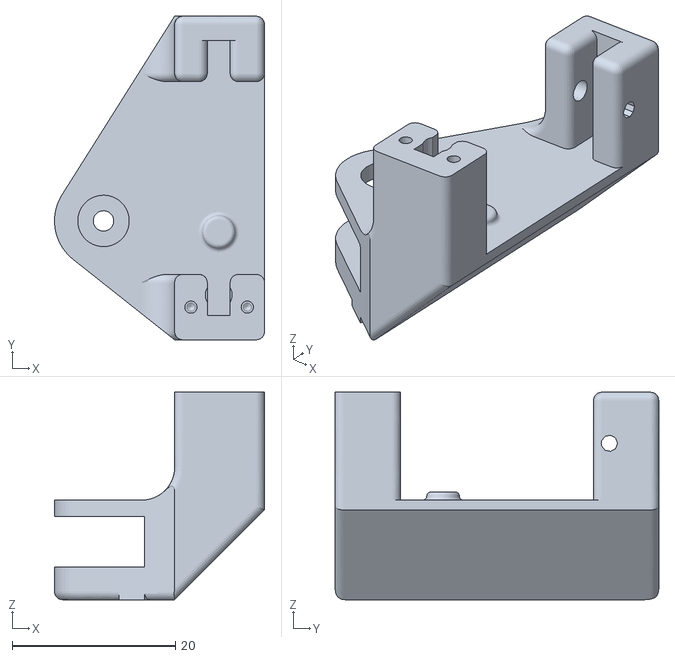
[picture p60: CAD file, 2024-06-10]
чертежи/Модели/корпус/Right Hand/Print as is/Новая папка/печать/R Thumb servo bracket.stl
25.7 x 39.6 x 25.4
