Umayva/Diplom/(list of files, cad)

Other CAD files:
RemoteFeeling/PCB2.DWG
RemoteFeeling/PCB2 top.DWG
RemoteFeeling/PCB2 bottom.DWG
чертежи/Модели/корпус/Right Hand/Print as is/Новая папка/печать/R_FingerServ.stl
