Umayva/Diplom/чертежи/Sheet4.pdf

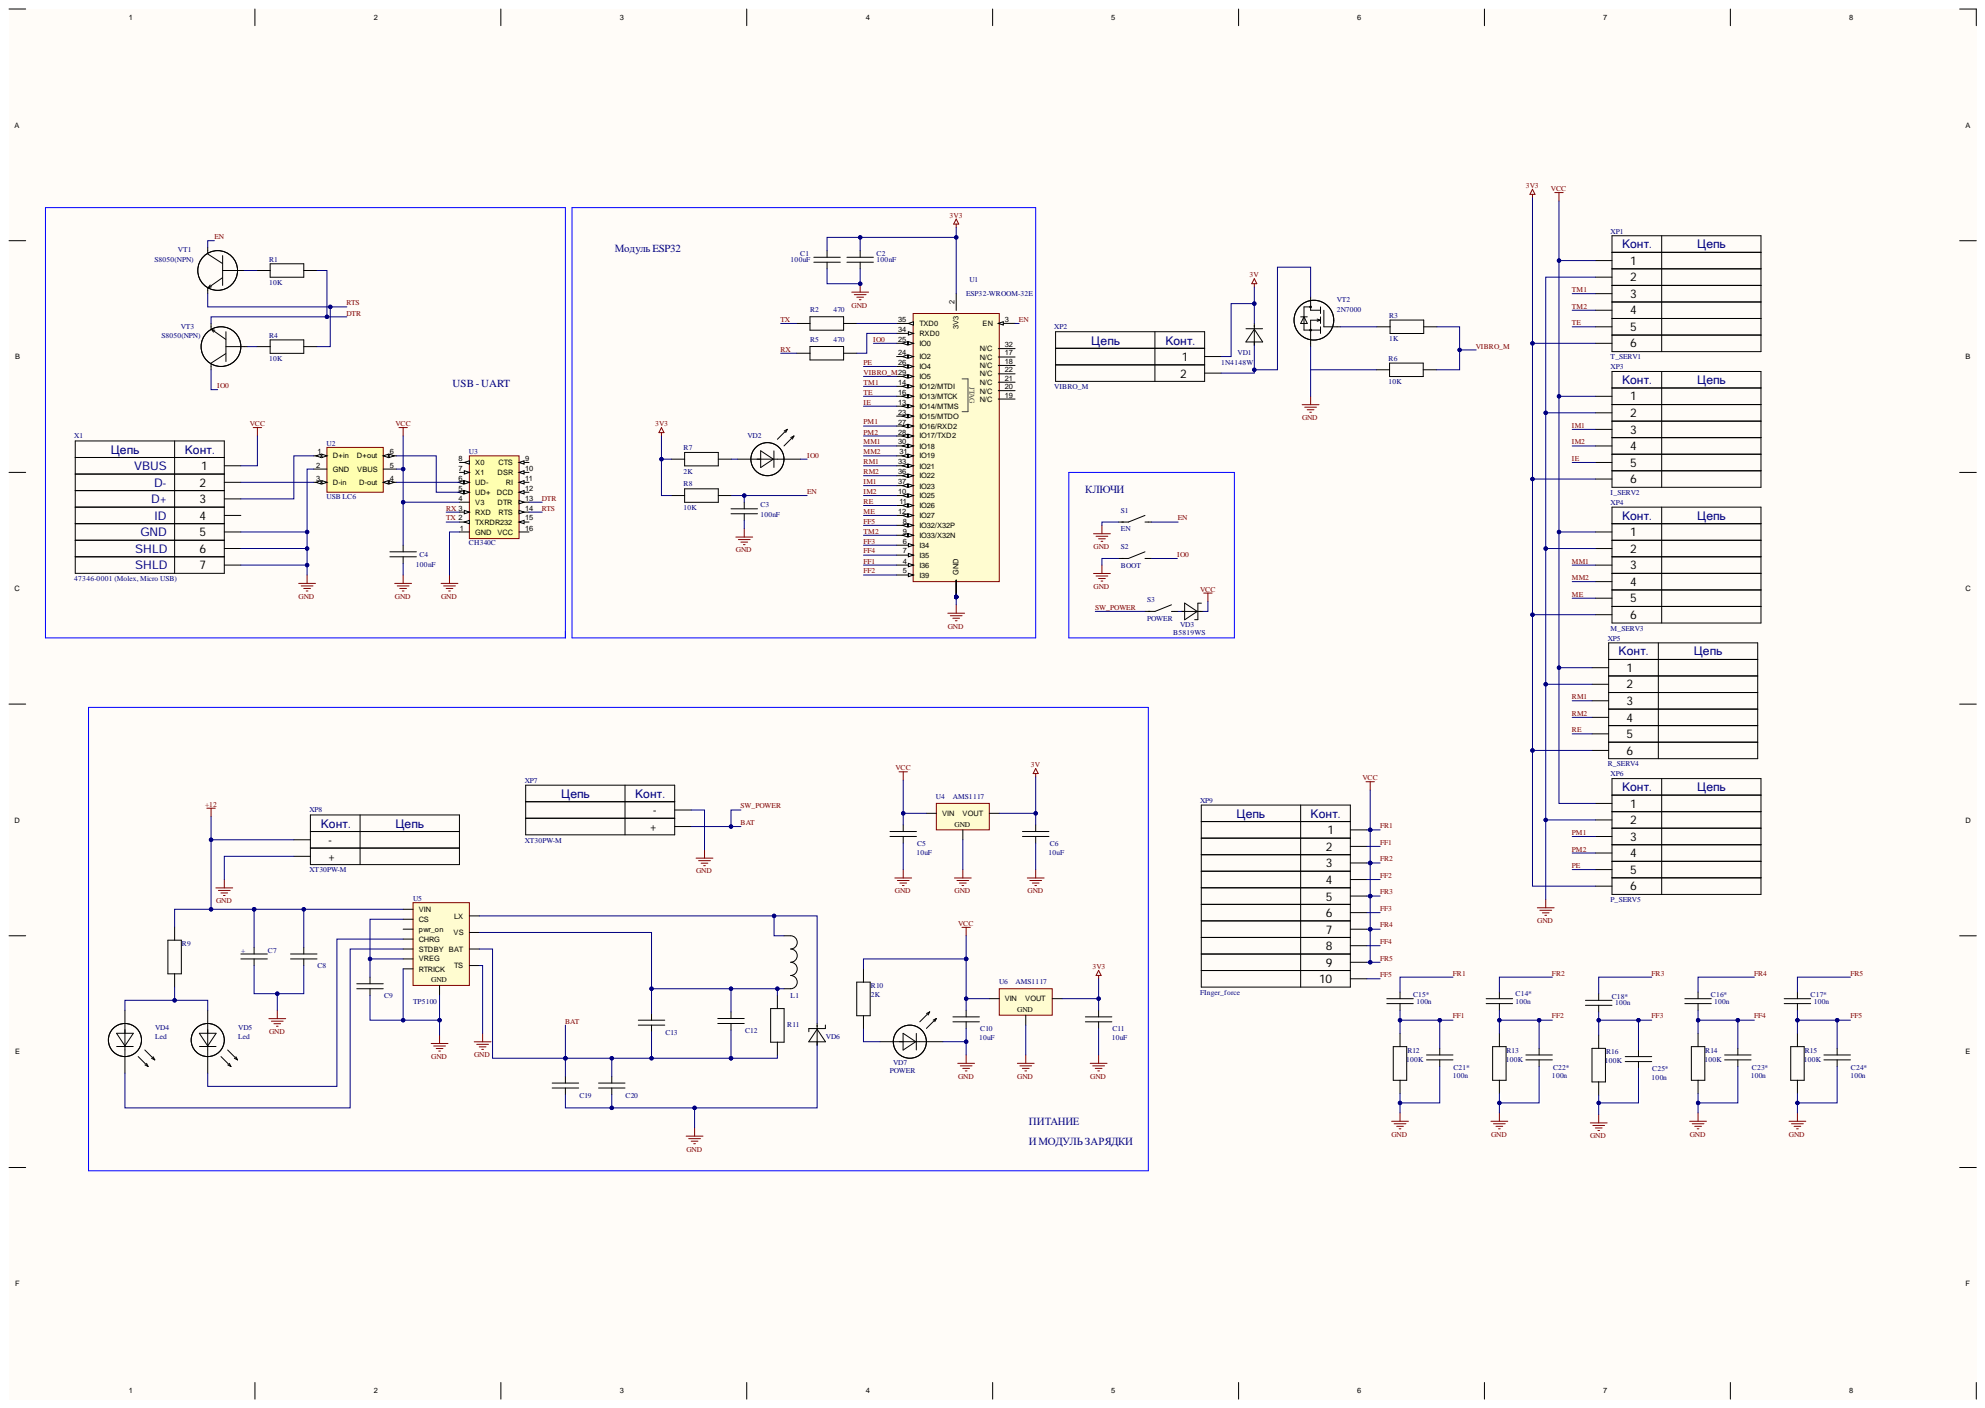
[picture p61: page 1]
