Umayva/Diplom/RemoteFeeling/PCB2.pdf

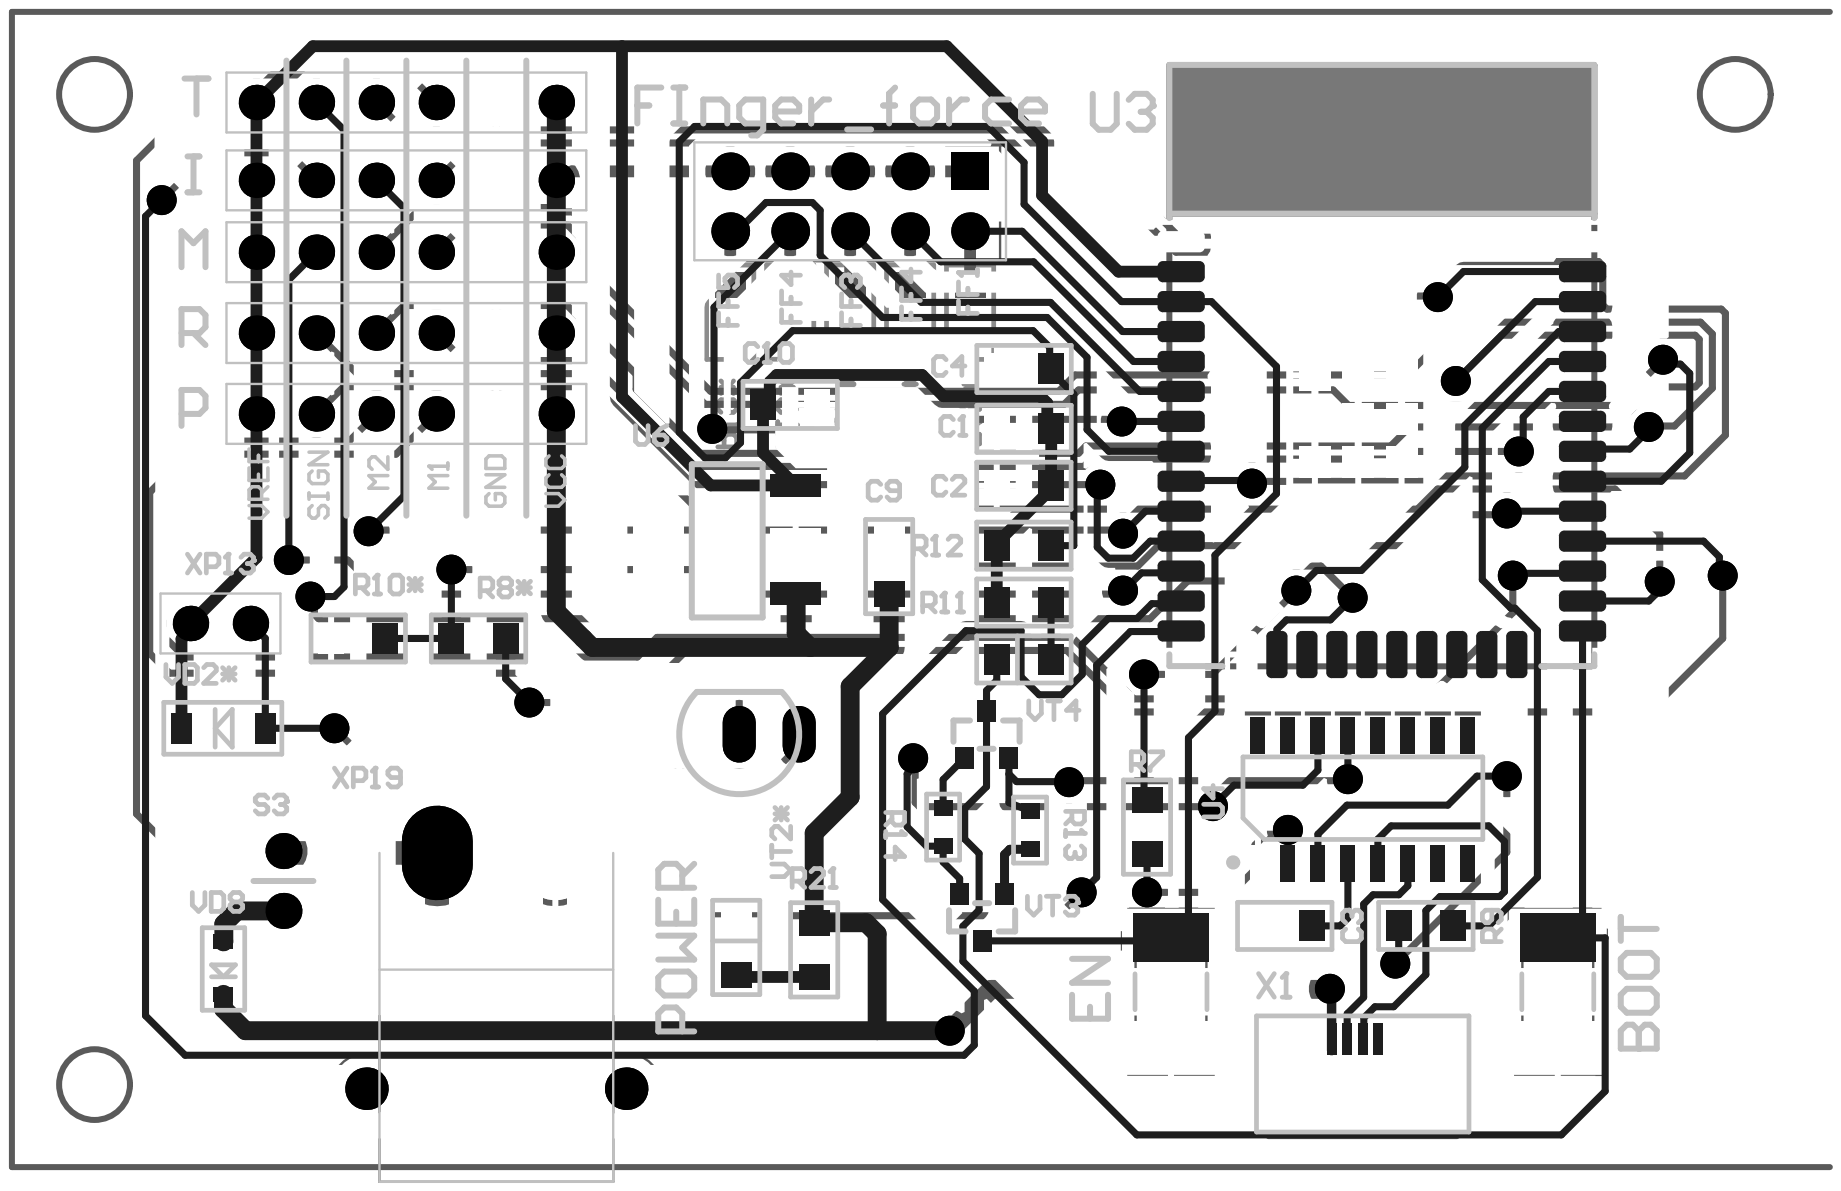
[picture p62: page 1]
