Umayva/Diplom/RemoteFeeling/Документация/PCB2.PcbDoc.pdf

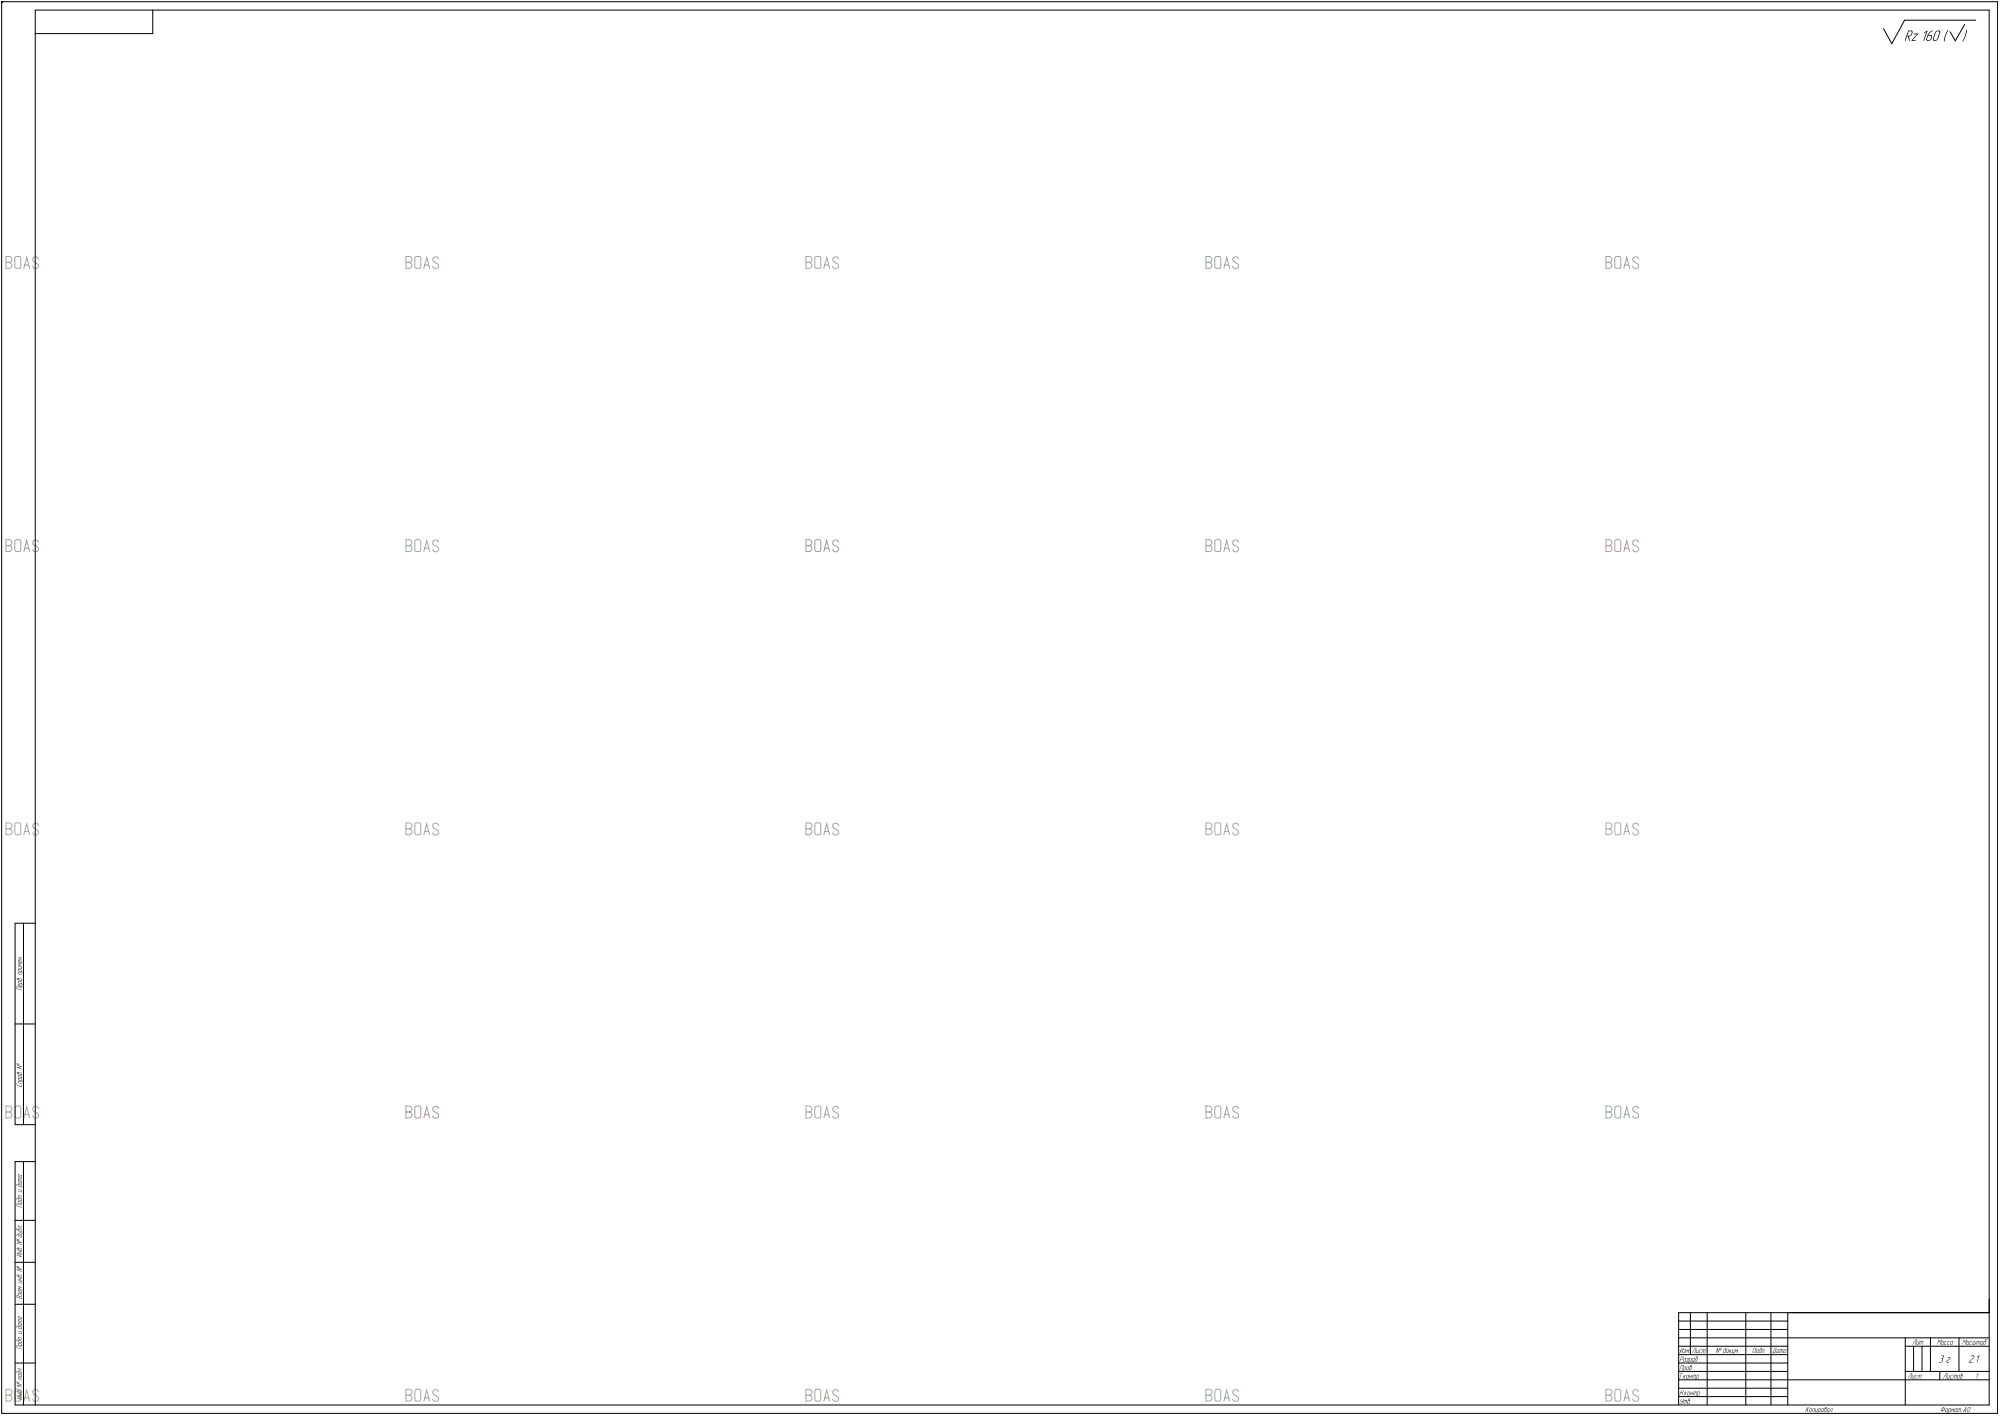
[picture p63: page 1]
