Umayva/Diplom/(list of files, drawings)

Other design files:
AltiumLibraries-master/AltiumLibraries.PrjPCB
AltiumLibraries-master/Fabrication/Fabrication.PrjPcb
AltiumLibraries-master/Fabrication/Panelization.PcbDoc
AltiumLibraries-master/Packages/Allwinner.PcbLib
AltiumLibraries-master/Packages/BGA.PcbLib
AltiumLibraries-master/Packages/Boards.PcbLib
AltiumLibraries-master/Packages/Connectors_Audio.PcbLib
AltiumLibraries-master/Packages/Connectors_DB.PcbLib
AltiumLibraries-master/Packages/Connectors_DIN.PcbLib
AltiumLibraries-master/Packages/Connectors_FPC.PcbLib
AltiumLibraries-master/Packages/Connectors_Header_1.27mm.PcbLib
AltiumLibraries-master/Packages/Connectors_Header_2.54mm.PcbLib
AltiumLibraries-master/Packages/Connectors_IDC.PcbLib
AltiumLibraries-master/Packages/Connectors_MemoryCards.PcbLib
AltiumLibraries-master/Packages/Connectors_MiniFIT.PcbLib
AltiumLibraries-master/Packages/Connectors_Misc.PcbLib
AltiumLibraries-master/Packages/Connectors_Power.PcbLib
AltiumLibraries-master/Packages/Connectors_SPOX.PcbLib
AltiumLibraries-master/Packages/Connectors_Terminals.PcbLib
AltiumLibraries-master/Packages/Connectors_USB.PcbLib
AltiumLibraries-master/Packages/Crystal.PcbLib
AltiumLibraries-master/Packages/CSP.PcbLib
AltiumLibraries-master/Packages/DDR.PcbLib
AltiumLibraries-master/Packages/DFN.PcbLib
AltiumLibraries-master/Packages/Diodes.PcbLib
AltiumLibraries-master/Packages/DirectFET.PcbLib
AltiumLibraries-master/Packages/DO.PcbLib
AltiumLibraries-master/Packages/LGA.PcbLib
AltiumLibraries-master/Packages/Misc.PcbLib
AltiumLibraries-master/Packages/Optocouplers.PcbLib
AltiumLibraries-master/Packages/Passive.PcbLib
AltiumLibraries-master/Packages/QFN.PcbLib
AltiumLibraries-master/Packages/QFP.PcbLib
AltiumLibraries-master/Packages/RF.PcbLib
AltiumLibraries-master/Packages/SO.PcbLib
AltiumLibraries-master/Packages/SOD.PcbLib
AltiumLibraries-master/Packages/SON.PcbLib
AltiumLibraries-master/Packages/SOP.PcbLib
AltiumLibraries-master/Packages/SOT.PcbLib
AltiumLibraries-master/Packages/TO.PcbLib
AltiumLibraries-master/PCBTemplates/Symbols.PcbDoc
AltiumLibraries-master/Schematic/Allwinner.SchLib
AltiumLibraries-master/Schematic/ARM_DDR.SchLib
AltiumLibraries-master/Schematic/AXP.SchLib
AltiumLibraries-master/Schematic/Connectors.SchLib
AltiumLibraries-master/Schematic/Crystal.SchLib
AltiumLibraries-master/Schematic/DDR.SchLib
AltiumLibraries-master/Schematic/Diodes.SchLib
AltiumLibraries-master/Schematic/Displays.SchLib
AltiumLibraries-master/Schematic/ICs.SchLib
AltiumLibraries-master/Schematic/Interfaces.SchLib
AltiumLibraries-master/Schematic/LEDs.SchLib
AltiumLibraries-master/Schematic/Memory.SchLib
AltiumLibraries-master/Schematic/MEMS.SchLib
AltiumLibraries-master/Schematic/Misc.SchLib
AltiumLibraries-master/Schematic/Optocouplers.SchLib
AltiumLibraries-master/Schematic/Passive.SchLib
AltiumLibraries-master/Schematic/Power.SchLib
AltiumLibraries-master/Schematic/RF.SchLib
AltiumLibraries-master/Schematic/Sensors.SchLib
AltiumLibraries-master/Schematic/STM32.SchLib
AltiumLibraries-master/Schematic/TI.SchLib
AltiumLibraries-master/Schematic/Transistors.SchLib
AltiumLibraries-master/Schematic/VoltageReferences.SchLib
AltiumLibraries-master/Snippets/Analog/AD623AR_simple.SchDoc
AltiumLibraries-master/Snippets/Analog/SnippetsAnalog.PrjPCB
AltiumLibraries-master/Snippets/Interfaces/CAN/CAN_ADM3053_Isolated_internal_DCDC.SchDoc
AltiumLibraries-master/Snippets/Interfaces/Ethernet/Ethernet_LAN8720_simple.SchDoc
AltiumLibraries-master/Snippets/Interfaces/Ethernet/Ethernet_LAN8742A_simple.SchDoc
AltiumLibraries-master/Snippets/Interfaces/RS232/RS232_MAX3232_simple.SchDoc
AltiumLibraries-master/Snippets/Interfaces/RS232/RS232_MAX3232_with_rts_cts.SchDoc
AltiumLibraries-master/Snippets/Interfaces/SnippetsInterfaces.PrjPCB
AltiumLibraries-master/Snippets/LED/NCV3066_simple.SchDoc
AltiumLibraries-master/Snippets/LED/SnippetsLED.PrjPCB
AltiumLibraries-master/Snippets/MCU/SnippetsMCU.PrjPCB
AltiumLibraries-master/Snippets/MCU/STM32F100CxT_simple.SchDoc
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
