Umayva/Diplom/(commit log)

2024-01-28 altium relise
    [PCB2.PcbDoc, Pakage_lib.SchLib, RemoteFeeling.PrjPcb, Sheet4.SchDoc]
2024-01-31 altium gerber
    [Connectors_USB.PcbLib, PCB2.PcbDoc, RemoteFeeling.PrjPcb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]
2024-02-03 lib edit
    [PCB2.DWG]
2024-02-03 Revert "lib edit"
    This reverts commit ef69874651d9f71c4a9acf59f17e7c93b477e0bc.
    [PCB2.DWG]
2024-02-05 чертежи
    [PCB2.brd]
2024-02-06 курсач
2024-04-15 реферат пп
2024-05-15 чертежи бета
    [CircuitWorks-SOT-23.STEP, PCB2 bottom.DWG, PCB2 top.DWG, PCB2.PcbDoc, Pakage_lib.SchLib, Pakage_lib.pcblib, User Library-SOT-23-6.STEP, спецификация.xlsx]
2024-05-16 принципиальная схема финал
2024-05-16 Revert "принципиальная схема финал"
    This reverts commit f592111cf8afe92bc07513df269a0e01a4fec3d2.
2024-05-17 описательно тех. часть
2024-05-18 Констр Расчет Эконом
    [спецификация.xlsx]
2024-05-18 оформление отчет пдп
2024-05-22 чертежи релиз
    [PCB2.PcbDoc, RemoteFeeling.PrjPcb, Sheet1.SchDoc, soic-16_150mil.step, sot223-4.step, to-92-100r.step]
2024-05-22 диплом(ранний доступ)
2024-05-25 чертежи финал, эконом бета
2024-05-29 Диплом альфа-релиз
    [CircuitWorks-SOT-23.STEP, User Library-SOT-23-6.STEP, soic-16_150mil.step, sot223-4.step, to-92-100r.step]
2024-05-31 норм.к
2024-05-31 Диплом(печать)
2024-06-02 Подготовка к защите1
2024-06-02 Выступление
2024-06-17 защита
    [Pakage_lib.SchLib, RemoteFeeling.PrjPcb, Разъемы.SchLib]
